Guignome01/OpenChess/BuildGuide/13_SENSOR_GLUE.webp

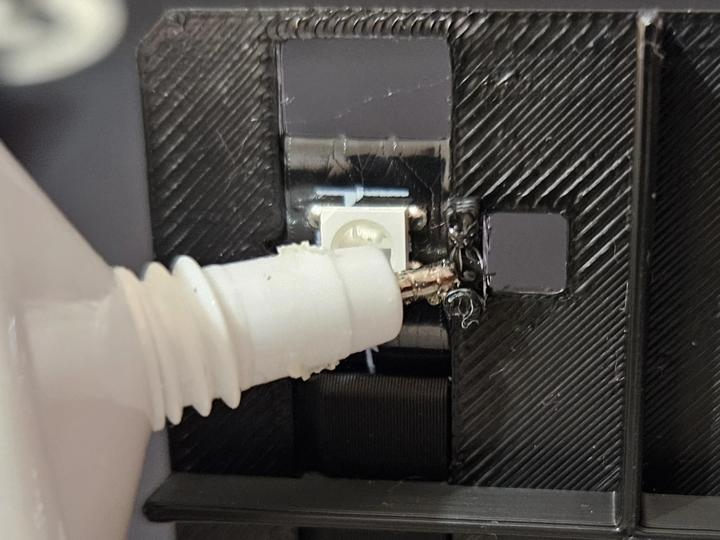
BuildGuide/13_SENSOR_GLUE.webp
