Guignome01/OpenChess/BuildGuide/39_PLASTIC_PCB_DONE_BACK.webp

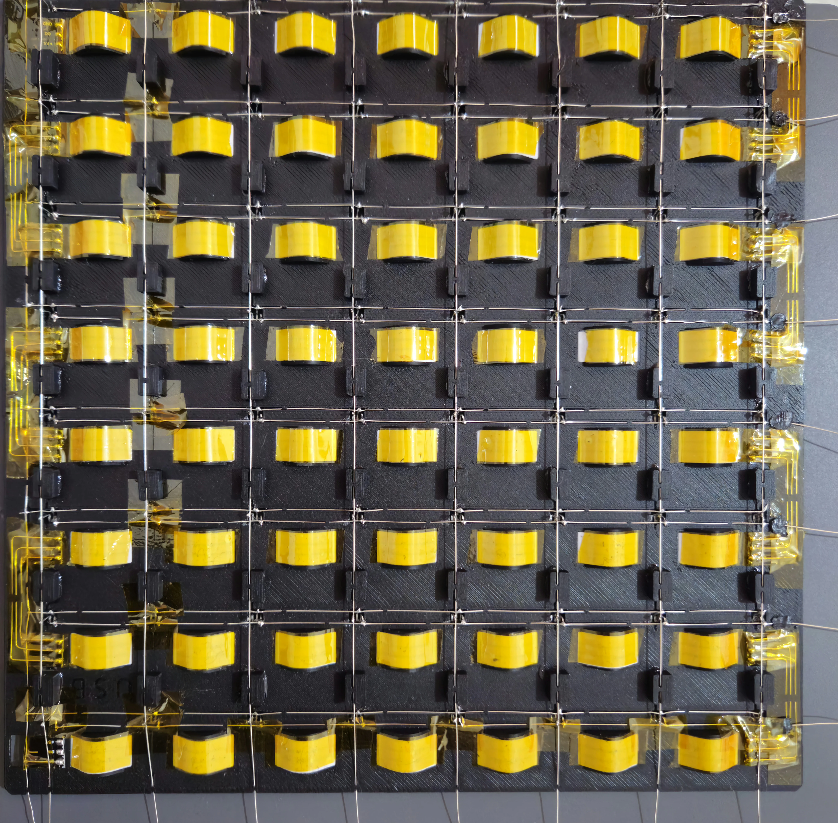
BuildGuide/39_PLASTIC_PCB_DONE_BACK.webp
