Guignome01/OpenChess/README.md

# LibreChess — Smart Chess Board

LibreChess is an open-source smart chessboard powered by an ESP32 microcontroller. It detects piece movements using hall-effect sensors, provides real-time visual feedback through an embedded LED grid, and connects to chess engines and online platforms over WiFi. Play human vs human, challenge the Stockfish engine, or join a live game on Lichess — all on a physical board with guided LED feedback.

## Features

### ♟ Gameplay
- Full chess rule enforcement: legal move validation, check, checkmate, stalemate, castling, en passant, pawn promotion
- Draw detection via 50-move rule and threefold repetition (Zobrist hashing)
- LED-highlighted valid moves on piece pickup (white for moves, red for captures, purple for en passant)
- Animated feedback for captures, promotions, check warnings, and game-ending events
- Physical resign gesture with progressive LED confirmation
- Game history saved to flash storage with crash recovery

### 🌐 Connectivity
- Play against Stockfish AI with 8 difficulty levels (beginner to master)
- Play live Lichess games on your physical board with automatic move synchronization
- WiFi management with up to 3 saved networks and automatic reconnection
- mDNS support for easy access via `librechess.local`

### 🖥 Web Interface
- Live board view with evaluation bar, move history, and move sounds
- Drag-and-drop board editor with FEN import/export
- Game history browser with full game review and PGN-style navigation
- WiFi, Lichess, LED brightness, and OTA firmware update settings
- Game mode selection and resign from the browser

## Quick Start

1. **Prerequisites** — Install [VS Code](https://code.visualstudio.com/) with the [PlatformIO IDE](https://platformio.org/install/ide?install=vscode) extension
2. **Flash** — Open the project workspace, connect your ESP32 via USB, and click Upload (`Ctrl+Alt+U`)
3. **Calibrate** — On first boot, the board runs a serial-guided calibration to map sensors and LEDs to board squares. Follow the prompts over serial monitor (115200 baud), or type `skip` to defer — but the board will ask again on each reboot until completed. See the [calibration guide](docs/guides/calibration.md).
4. **Connect** — Connect to the `LibreChess` WiFi AP (password: `chess123`), open `http://librechess.local`, and configure your WiFi network
5. **Play** — Place a piece on one of the four lit center squares to select a game mode

See the [installation guide](docs/development/installation.md) for detailed setup instructions, the [full documentation](docs/overview.md) for hardware guides and development reference, and the [roadmap](docs/roadmap.md) for planned features.

## Contributing

Contributions are welcome. Whether it's a bug fix, a new feature, or feedback on the project direction, feel free to open an issue or submit a pull request.

## License

This project is open source. See the [LICENSE](LICENSE) file for details.
