Guignome01/OpenChess/docs/development/project-structure.md

# Project Structure

A comprehensive map of the codebase, covering firmware, web frontend, build tools, and runtime storage.

## Top-Level Layout

```
├── src/                    Firmware source code and web frontend sources
├── lib/core/               Natively-compilable chess engine library (no Arduino deps)
├── test/                   Native unit tests (PlatformIO Unity framework)
├── data/                   Pre-built web assets (gzip-compressed) for LittleFS
├── docs/                   Project documentation
├── BuildGuide/             Build photos and schematics (to be updated)
├── platformio.ini          PlatformIO build configuration
├── LibreChess.code-workspace VS Code workspace file
├── grid_scan_test.cpp      Standalone sensor grid debugging utility
├── .clang-format           C++ code formatting rules (Google style base)
├── .github/                Copilot instructions, scoped instruction files, and workflow skills
├── LICENSE                 Project license
└── README.md               Project overview and quick start
```

## Firmware (`src/`)

### Core

| File | Purpose |
|---|---|
| `main.cpp` | Entry point: `setup()` and `loop()`. Game mode selection, menu routing, WiFi/resign/board-edit relay, and game lifecycle management. |
| `board_driver.h/.cpp` | Hardware abstraction: LED strip (NeoPixelBus, I2S DMA), sensor grid (shift register scan + GPIO reads), calibration (NVS-persisted), LED settings (brightness, dimming), and async animation queue (FreeRTOS task + queue). GPIO pin definitions. |
| `system_utils.h/.cpp` | Arduino/ESP32 utility functions: `colorLed()` (piece char → LED color), `ensureNvsInitialized()` (Preferences guard). Not available in native tests. |
| `led_colors.h` | `LedRGB` struct and named color constants (Cyan, White, Red, Green, Yellow, Purple, Orange, Blue, etc.) with `scaleColor()` brightness helper. |

### Game Modes

| File | Purpose |
|---|---|
| `game_mode/game_mode.h/.cpp` | Abstract base class for all game modes. Holds a `Game*` that orchestrates chess state, recording, and observer notification. Implements shared logic: `tryPlayerMove()`, `applyMove()` (delegates to `Game::makeMove()`; the string overload parses coordinate notation), `waitForBoardSetup()`, `tryResumeGame()`, resign gesture handling, and LED feedback helpers. No longer includes `movegen.h + rules.h` directly — all chess queries go through the game orchestrator. |
| `game_mode/bot_mode.h/.cpp` | Concrete class for human-vs-engine play (composition pattern). Composes an `EngineProvider*` via strategy injection. Non-blocking `update()` drives an async state machine (`BotState::PLAYER_TURN` / `BotState::ENGINE_THINKING`): player turn → `tryPlayerMove()` → `applyMove()` → `provider_->onPlayerMoveApplied()`; engine turn → `provider_->requestMove()` (spawns FreeRTOS task) → polls `provider_->checkResult()` each tick. Provides thinking animation helpers, remote-move LED guidance (`waitForRemoteMoveCompletion()`), and resign hooks that delegate to the provider. |
| `game_mode/player_mode.h/.cpp` | Human vs Human mode. Minimal subclass of `GameMode` — implements `begin()` (board setup, game recording) and `update()` (sensor polling, move processing). |
| `sensor_test.h/.cpp` | Standalone sensor diagnostic mode (does not inherit `GameMode`). Tracks visited squares, lights them white, completes when all 64 are visited. |

### Engine Providers

| File | Purpose |
|---|---|
| `engine/engine_provider.h` | `EngineProvider` base class. Defines the contract for all chess engines: `initialize()`, `requestMove()` / `checkResult()` / `cancelRequest()` (async move computation), `onPlayerMoveApplied()`, `onResignConfirmed()`, `getEvaluation()`. Also owns the shared FreeRTOS task lifecycle (`BaseTaskContext`, `spawnTask()`, `pollResult()`, `peekResult()`, `finishTask()`). Defines `EngineResult` (move/game-end data) and `EngineInitResult` (player color, FEN, mode, depth, resume flag). |
| `engine/stockfish/stockfish_provider.h/.cpp` | `StockfishProvider`: extends `EngineProvider`, spawns a one-shot FreeRTOS task per move that calls `StockfishAPI`. `TaskContext` extends `BaseTaskContext` with FEN, depth, and evaluation fields. Retry logic with cancel checking between attempts. |
| `engine/stockfish/stockfish_api.h/.cpp` | Stockfish API client. Builds request URLs, parses JSON responses (evaluation, best move, continuation). Connects to `stockfish.online` over HTTPS. |
| `engine/stockfish/stockfish_settings.h` | 8 difficulty presets (beginner through master, depths 1–15, scaled timeouts 10s–65s). `StockfishSettings::fromLevel(int)` factory. |
| `engine/lichess/lichess_provider.h/.cpp` | `LichessProvider`: extends `EngineProvider`, blocking `initialize()` discovers active games (token verification + event polling). `requestMove()` spawns a FreeRTOS task that opens a persistent NDJSON stream and reads events; reconnects with exponential backoff on connection loss. `onPlayerMoveApplied()` sends moves to Lichess with retries. `onResignConfirmed()` resigns on the server. |
| `engine/lichess/lichess_api.h/.cpp` | Lichess API client. Token management, game event polling, persistent game stream (`connectGameStream()` / `readStreamEvent()`), move submission, and resignation. Connects to `lichess.org` over HTTPS. |
| `engine/lichess/lichess_config.h` | `LichessConfig` struct: holds the Lichess API token. |
| `engine/librechess/librechess_provider.h/.cpp` | `LibreChessProvider`: extends `EngineProvider`, runs the on-board search engine in-process. Each `requestMove()` spawns a FreeRTOS task (16 KiB stack) that creates a `UCIHandler` with heap-sized TT, sends `position fen` + `go depth/movetime`, and extracts the `bestmove` response. Cancellation via `setExternalStop()`. No network required. |
| `engine/librechess/librechess_serial.h` | `SerialUCIStream`: `UCIStream` implementation over hardware UART. Enables external UCI GUIs (Arena, CuteChess) to drive the engine over Serial. |

### Infrastructure

| File | Purpose |
|---|---|
| `wifi_manager_esp32.h/.cpp` | WiFi connection management (state machine with AP/STA modes), async web server (ESPAsyncWebServer), all HTTP API endpoints, mDNS, known-networks registry (NVS), OTA password management, and board state relay to the web UI. |
| `littlefs_storage.h/.cpp` | Concrete `IGameStorage` backed by LittleFS. Manages `/games/` directory, binary game files (header + moves + FEN table), storage limits enforcement, and JSON game list API for the web UI. |
| `serial_logger.h/.cpp` | Concrete `ILogger` using Arduino `Serial`. |
| `board_menu.h/.cpp` | Reusable board menu primitive. Displays options as colored LEDs, uses two-phase debounce for selection, supports orientation flipping, back buttons, and blink feedback. Also provides `boardConfirm()` dialog. |
| `menu_navigator.h/.cpp` | Stack-based menu orchestrator (max depth 4). Push/pop navigation, auto back-button handling, parent menu re-display. |
| `menu_config.h/.cpp` | Menu layout definitions. `MenuId` namespace with ID ranges per level, `constexpr MenuItem[]` arrays for each menu, extern menu/navigator instances, and `initMenus()` two-phase initializer. |

## Web Frontend (`src/web/`)

The ESP32 serves a web interface directly from flash storage. The frontend is built with vanilla HTML, CSS, and JavaScript — no build framework or SPA router. Each page is a self-contained HTML file that includes shared scripts.

### Pages

| File | Purpose |
|---|---|
| `index.html` | Home and settings page. WiFi network management, Lichess token, LED brightness/dimming, board recalibration, OTA firmware upload, and OTA password security. |
| `board.html` | Board view and interaction page. Live board display with evaluation bar, move history with navigation, board editor (drag-and-drop, FEN, castling/en-passant controls), game history browser, game review mode, settings popup (themes, colors, sounds), focus mode, and resign button. |
| `game.html` | Game mode selection page. Four mode cards with bot configuration panel (color, difficulty). Redirects to board page after selection. |

### Scripts (`src/web/scripts/`)

| File | Purpose |
|---|---|
| `api.js` | Low-level HTTP utilities: `getApi()`, `postApi()`, `deleteApi()` fetch wrappers and `pollHealth()` for OTA reboot polling. |
| `provider.js` | Domain-specific API client. `Api` object with named methods for every backend endpoint (e.g., `Api.getNetworks()`, `Api.resign()`, `Api.selectGame()`). All pages use `Api.*` methods — no page contains raw fetch calls. |
| `Position-1.0.0.min.js` | Third-party Position rendering library. |
| `jquery-4.0.0.min.js` | jQuery (dependency of Position.js). |

### Styles (`src/web/css/`)

| File | Purpose |
|---|---|
| `styles.css` | Application styles. Dark theme, responsive layout, game mode cards, board controls, evaluation bar, FEN editor, OTA dropzone, settings popup, game history cards, review panel. |
| `Position-1.0.0.min.css` | Third-party Position styles. |

### Assets

- `src/web/pieces/` — SVG chess piece images (12 files: `wK.svg`, `bQ.svg`, etc.)
- `src/web/sounds/` — Move sounds (`move.nogz.mp3`, `capture.nogz.mp3`). The `.nogz.` naming convention prevents gzip compression in the build pipeline — these are served as raw binary files.

## Chess Engine Library (`lib/core/`)

The `lib/core/` library contains all natively-compilable chess logic with zero Arduino dependencies. PlatformIO's Library Dependency Finder auto-discovers it for both the ESP32 and native test environments. All code uses `std::string` (not Arduino `String`); firmware call sites bridge with `.c_str()` / `std::string()`.

| File | Purpose |
|---|---|
| `library.json` | PlatformIO library descriptor. |
| `src/piece.h` | `piece` namespace (header-only): type-safe piece representation (Piece/Color/PieceType enums, bit extraction, construction, predicates, color helpers, FEN char conversion, Zobrist index, material values). |
| `src/bitboard.h` | `LibreChess` (bitboard) namespace (header-only): bitboard types (`Bitboard = uint64_t`, `Square = int`), LERF square mapping (`squareOf`, `rowOf`, `colOf`), bit manipulation (`popcount`, `lsb`, `popLsb`), file/rank masks, directional shifts (compass rose convention), `BitboardSet` struct (12 piece + 2 color + occupancy bitboards with `setPiece`/`removePiece`/`movePiece`). |
| `src/attacks.h/.cpp` | `attacks` namespace: precomputed leaper tables (`KNIGHT[64]`, `KING[64]`, `PAWN[2][64]`, ~2.5 KiB), O(1) slider functions (`rook` via first-rank table + Hyperbola Quintessence, `bishop` via HQ on diagonal masks, `queen` = rook+bishop), x-ray functions (`xrayRook`, `xrayBishop`), ray geometry (`between`, `line`), `AttackInfo` struct + `computeAll(bb)` (per-piece-type/color attack maps for evaluation/search), `isSquareUnderAttack(bb, sq, color)` (check detection via attack table lookups), `init()` initializer. |
| `src/movegen.h + rules.h/.cpp` | `movegen`/`rules` namespaces: stateless chess logic. Move generation (fills `MoveList&`), legal move filtering via copy-make on `BitboardSet`, check/checkmate/stalemate detection. All functions take `const BitboardSet& bb` + `const Piece mailbox[]`; check detection delegates to `attacks::isSquareUnderAttack()`. Position-dependent state (castling rights, en passant target) is passed in via `const PositionState&`. |
| `src/position.h/.cpp` | `Position` class: board representation and position-level chess logic — a pure position container with no lifecycle state. Owns `BitboardSet bb_` (12 piece bitboards + 2 color + occupancy), `Piece mailbox_[64]` (flat array for O(1) piece identity), current turn, and all position state via `PositionState` (castling rights, en passant, halfmove/fullmove clocks). Incremental Zobrist hash (`hash_`). King cache (`Square kingSquare_[2]`). Insufficient material detection (K vs K, K+B/N vs K, K+B vs K+B same-color). Public API: `newGame()`, `loadFEN()` → `bool` (validates FEN before applying; returns false on invalid input), `makeMove()` → `MoveResult`, `getFen()`, `getEvaluation()`, `getCastlingRights()`, `positionState()`, `bitboards()`, `mailbox()`. Convenience wrappers: `getPossibleMoves()`, `isCheck()`, `inCheck()`, `isCheckmate()`, `isStalemate()`, `isInsufficientMaterial()`, `isDraw()`, `isFiftyMoves()`, `isAttacked()`, `findPiece()`, `checkEnPassant()`, `checkCastling()`, `moveNumber()`. Note: lifecycle state (`gameOver_`, `gameResult_`, `winnerColor_`) and lifecycle methods (`endGame()`, `isGameOver()`) live in `Game`. Move history, observer notification, undo/redo, and batching also live in `Game`. |
| `src/utils.h/.cpp` | `utils` namespace: board-level helpers — board queries (`isValidSquare`), coordinate helpers (`squareName`, `fileChar`, `rankChar`, `fileIndex`, `rankIndex`), validation (`isValidPromotionChar`), castling rights formatting/parsing, special-move analysis structs (`checkEnPassant`, `checkCastling`, `updateCastlingRights`), `applyBoardTransform` (applies move to `BitboardSet` + `mailbox` + `hash`), `boardToText(mailbox)`, `gameResultName`. |
| `src/evaluation.h/.cpp` | `eval` namespace: tapered position evaluation — `evaluatePosition(bb)` computes separate midgame and endgame scores (material + phase-specific PSTs + pawn structure via file-scoped pawn mask arrays), then interpolates based on game phase (non-pawn material: N=1, B=1, R=2, Q=4; max 24). Endgame PSTs for king (centralization) and pawn (advancement) differ from midgame; other pieces share PSTs. Returns score in centipawns. Pawn-structure analysis functions (`isPassed`, `isIsolated`, `isDoubled`, `isBackward`) and `initPawnMasks()` lazy initializer. |
| `src/iterator.h` | `iterator` namespace (header-only): board iteration helpers built on bitboard serialization. `forEachSquare(mailbox, fn)` loops 0–63. `forEachPiece(bb, mailbox, fn)` iterates occupied squares via `popLsb`. `somePiece(bb, mailbox, fn)` early-exit variant. `findPiece(bb, piece, positions, max)` locates pieces via their bitboard. All callbacks receive `(row, col, piece)`. |
| `src/fen.h/.cpp` | `fen` namespace: FEN string handling — `boardToFEN()` (mailbox → FEN string), `fenToBoard()` (FEN string → `BitboardSet` + `mailbox` + state), `validateFEN()` (format validation: rank structure, piece chars, turn, castling, en passant, clocks). |
| `src/notation.h/.cpp` | `notation` namespace: move notation conversion — coordinate (`"e2e4"`), SAN (`"Nf3"`), LAN (`"Ng1-f3"`) output and parsing. All functions are pure (`const BitboardSet&` + `const Piece mailbox[]` passed in). |
| `src/types.h` | Shared chess types: `Piece`/`Color`/`PieceType` enums, `PositionState` struct (castling rights, en passant target, halfmove/fullmove clocks) with `initial()` static factory, `GameResult` enum class, `MoveResult` struct (returned by `Position::makeMove()`), `MoveEntry` struct (move log record), `Move` struct (3 bytes: from/to/flags with capture, EP, castling, promotion bits), `ScoredMove` struct (Move + int16_t score), `MoveList` struct (fixed-size `Move[218]` array + count, used by both per-piece and bulk move generation, with `targetRow`/`targetCol`/`target` adapter accessors for UI), `HashHistory` struct (Zobrist hash array + count, used by `Position`), `GameHeader` packed struct (16 bytes), `GameModeId` enum class, `MoveFormat` enum class (`COORDINATE`, `SAN`, `LAN`), storage constants (`FORMAT_VERSION`, `FEN_MARKER`, `MAX_GAMES`, `MAX_USAGE_PERCENT`), `invalidMoveResult()` factory. |
| `src/zobrist.h` | `zobrist` namespace (header-only): constexpr-generated Zobrist keys, piece-index mapping, and full-board hash computation (`computeHash(bb, mailbox, turn, state)`). `Position` uses incremental hashing via XOR deltas in `applyMoveToBoard()`; `computeHash()` is retained for debug verification. |
| `src/search.h/.cpp` | `search` namespace: on-board chess engine — negamax with alpha-beta pruning, quiescence search, iterative deepening, transposition table (`TTEntry` 12 bytes, `TranspositionTable`), move ordering (TT move → MVV-LVA → killers → history). `findBestMove(pos, limits, timeFunc, infoCallback, tt)` is the single public entry point. `SearchLimits` (depth/time/stop), `SearchResult` (bestMove/score/depth/nodes), `SearchState` (per-search heuristics). Constants: `MATE_SCORE`, `INF_SCORE`, `MAX_PLY`, `DEFAULT_TT_SIZE`. |
| `src/uci.h/.cpp` | `uci` namespace: transport-agnostic UCI protocol handler. `UCIStream` (abstract I/O), `UCIHandler` (owns Position + TT + stop flag, dispatches `uci`/`isready`/`ucinewgame`/`position`/`go`/`stop`/`quit`), `StringUCIStream` (in-memory I/O for testing/in-process use). `setExternalStop()` wires FreeRTOS cancellation. Simple time management (remaining/30 + increment/2). |
| `src/history.h/.cpp` | `History` class: in-memory game history and persistent game recording. Ordered move log (`MoveEntry` structs with full move metadata including previous position state), Zobrist hash tracking for threefold repetition detection, and game recording lifecycle (compact 2-byte move encoding via static `encodeMove()`/`decodeMove()`, manages `GameHeader`, delegates persistence to `IGameStorage`, flushes header every full turn to reduce flash wear, validates moves during replay, replays games directly into a `Position`). Fixed-size arrays (ESP32-friendly). Composed by `Game`. |
| `src/game.h/.cpp` | `Game` class: central game orchestrator. Composes `Position`, `History`, and optionally `IGameObserver`. Constructor: `(IGameStorage*, IGameObserver*, ILogger*)`. All chess-state mutations flow through this class. Handles threefold repetition detection (via Zobrist hashing), move history recording, persistent game recording (delegated to `History`), observer notification, and batching. Exposes `bitboards()` and `mailbox()` accessors, iterator helpers (`forEachSquare`, `forEachPiece`, `somePiece`), and notation convenience methods (`makeMove(string)`, `toCoordinate()`, `parseCoordinate()`, `parseMove()`, `getHistory(format)`) so firmware never needs to include core headers directly. |
| `src/logger.h` | `ILogger` abstract interface: `info()`, `error()`, and `infof()`/`errorf()` formatted helpers. |
| `src/observer.h` | `IGameObserver` abstract interface: `onBoardStateChanged(fen, evaluation)`. |
| `src/storage.h` | `IGameStorage` abstract interface: game file lifecycle (begin, append, finalize, discard), read-back for replay, and storage management. |

## Unit Tests (`test/`)

Native unit tests using the PlatformIO Unity framework. All engine tests are consolidated in a single `test_core/` suite.

```
test/
├── test_helpers.h                  Shared utilities (setupInitialBoard, clearBoard, placePiece, etc.)
└── test_core/
    ├── test_core.cpp             Main entry: setUp/tearDown, shared globals, register calls
    ├── test_attacks.cpp                 attacks: leaper tables, slider attacks (+ bulk reference cross-check), x-ray attacks, geometry rays, AttackInfo
    ├── test_bitboard.cpp                LibreChess: square mapping roundtrip, bit ops, square-color masks, BitboardSet mutations
    ├── test_evaluation.cpp              eval: material scoring, pawn structure, tapered evaluation, pawn analysis functions
    ├── test_fen.cpp                     FEN round-trip, boardToFEN/fenToBoard, validateFEN (valid/invalid positions, fields)
    ├── test_game.cpp                    Game: threefold repetition, draw detection, observer notification/batching, history
    ├── test_history.cpp                 History: move log with undo/redo, branch-on-undo
    ├── test_history_persistence.cpp     History recording: persistence lifecycle, header flush, replay, branch-truncation, compact encode/decode
    ├── test_iterator.cpp                Board iteration: forEachSquare, forEachPiece, somePiece, findPiece
    ├── test_movegen.cpp                 Move generation per piece type, captures, bulk generation, legal move queries
    ├── test_notation.cpp                Coordinate/SAN/LAN output and parsing, auto-format detection, roundtrip
    ├── test_piece.cpp                   piece: type extraction, predicates, FEN chars, material values, Zobrist index, color helpers
    ├── test_position.cpp                Position: moves, special moves, draws, FEN, API queries
    ├── test_rules.cpp                   rules: check/checkmate/stalemate, pin-aware generation, castling, en passant, promotion
    ├── test_utils.cpp                   utils: 50-move rule, castling rights, coordinate helpers, board transforms
    ├── test_zobrist.cpp                 Zobrist hashing: key determinism, computeHash, position sensitivity
    ├── test_search.cpp                  search: mate-in-1, captures, quiescence, stalemate avoidance, iterative deepening, time/stop control, TT store/probe/clear/pack/mate-score, move ordering
    └── test_uci.cpp                     uci: id/isready output, position startpos/fen/moves, go depth/info, newgame, quit, unknown commands, loop
    ├── test_search.cpp                  search: mate-in-1, captures, quiescence, stalemate avoidance, iterative deepening, time/stop control, TT store/probe/clear/pack/mate-score, move ordering
    └── test_uci.cpp                     uci: id/isready output, position startpos/fen/moves, go depth/info, newgame, quit, unknown commands, loop
```

Run with `pio test -e native`. See [PlatformIO Unit Testing docs](https://docs.platformio.org/en/latest/advanced/unit-testing/index.html).

## Build Scripts (`src/web/build/`)

| File | Purpose |
|---|---|
| `minify.py` | Pre-build: minifies HTML/CSS/JS from `src/web/` → `src/web/build/`. Skips gracefully if npm tools aren't installed. |
| `prepare_littlefs.py` | Pre-build: gzip-compresses web assets into `data/` for LittleFS. Respects the `.nogz.` convention. Cleans intermediate files after. |
| `upload_fs.py` | Build hook: hashes `data/` contents and only uploads the LittleFS image when assets change. |

## Filesystem (`data/`)

The `data/` directory contains pre-built, gzip-compressed web assets ready for LittleFS upload. This directory is committed to the repository so the project can be built and flashed without npm minification tools.

```
data/
├── index.html.gz
├── board.html.gz
├── game.html.gz
├── favicon.svg.gz
├── css/          *.css.gz
├── scripts/      *.js.gz
├── pieces/       *.svg.gz
└── sounds/       *.mp3 (raw, not gzipped)
```

`ESPAsyncWebServer` detects `.gz` files and serves them with `Content-Encoding: gzip` automatically. Sound files are served raw with `setTryGzipFirst(false)`.

## LittleFS Runtime Layout

At runtime, the firmware creates additional files on the LittleFS partition:

```
/games/
├── live.bin        Active game data (header + moves) — crash recovery
├── live_fen.bin    Active game FEN snapshots — crash recovery
├── 0001.bin        Completed game #1
├── 0001_fen.bin    FEN table for game #1
├── ...
```

Storage limits: maximum 50 saved games, capped at 80% of LittleFS capacity.

## Configuration

LibreChess has no editable configuration file. All settings are persisted in ESP32 NVS (non-volatile storage) and managed through the web UI or code constants:

| Setting | Storage | How to Change |
|---|---|---|
| WiFi networks (up to 3) | NVS `"wifiNets"` | Web UI WiFi Settings |
| Lichess API token | NVS `"wifiCreds"` | Web UI Lichess Settings |
| OTA password | NVS `"ota"` (salted SHA-256) | Web UI Security Settings |
| LED brightness | NVS `"boardSettings"` | Web UI Board Settings |
| Dark square dimming | NVS `"boardSettings"` | Web UI Board Settings |
| Calibration data | NVS `"calibration"` | Auto (first boot) or Web UI recalibrate button |
| GPIO pin assignments | `board_driver.h` `#define`s | Edit source code |
| Board, framework, libraries | `platformio.ini` | Edit file |
| Factory reset | `platformio.ini` build flag | Add `-DFACTORY_RESET` to `build_flags` |
