Guignome01/OpenChess/BuildGuide/46_GLUE_PARCHMENT_PAPER.webp

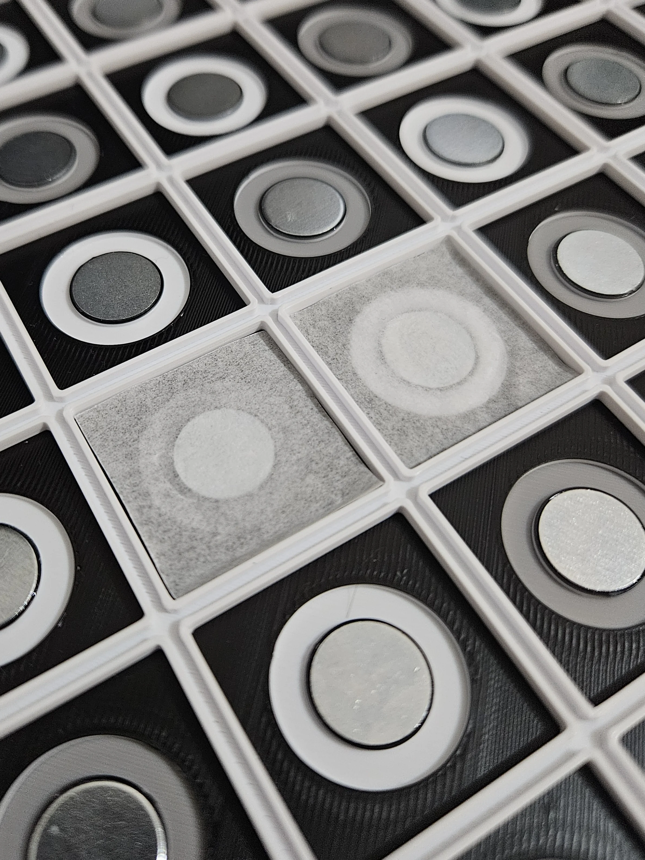
BuildGuide/46_GLUE_PARCHMENT_PAPER.webp
