Guignome01/OpenChess/BuildGuide/schematics/ESP32_PCB.webp

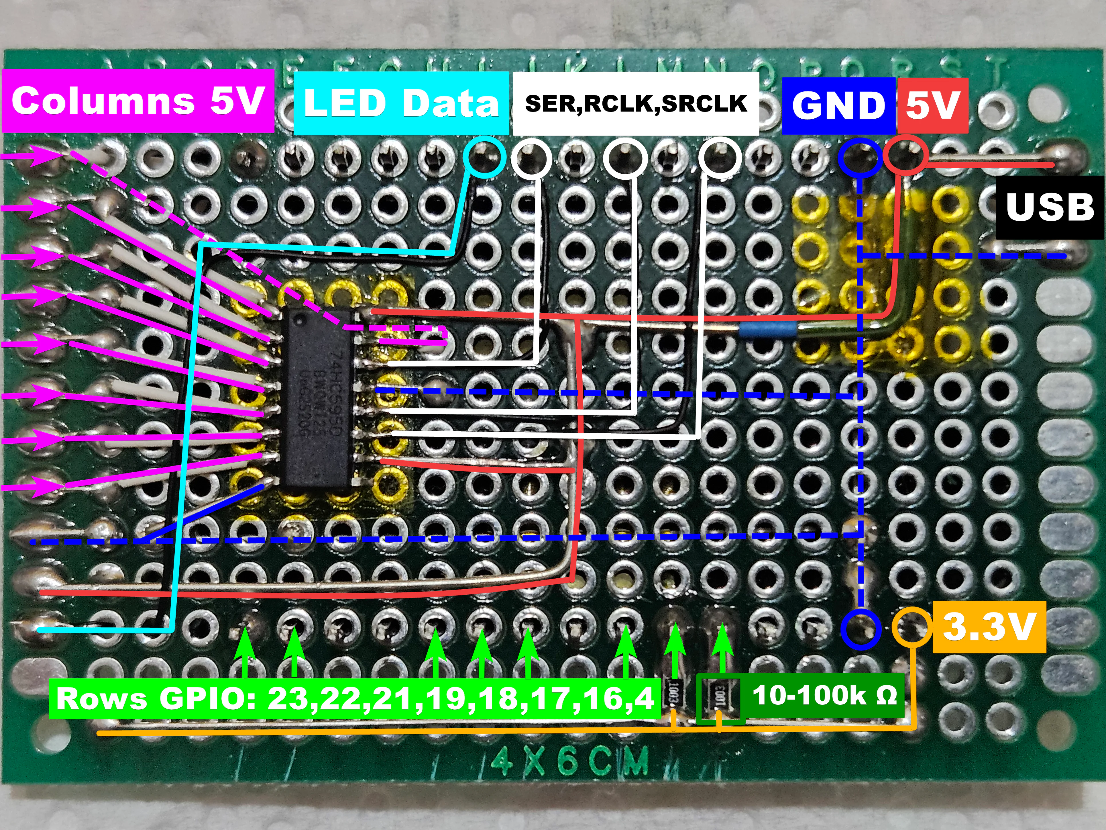
BuildGuide/schematics/ESP32_PCB.webp
