Guignome01/OpenChess/BuildGuide/schematics/NPN.webp

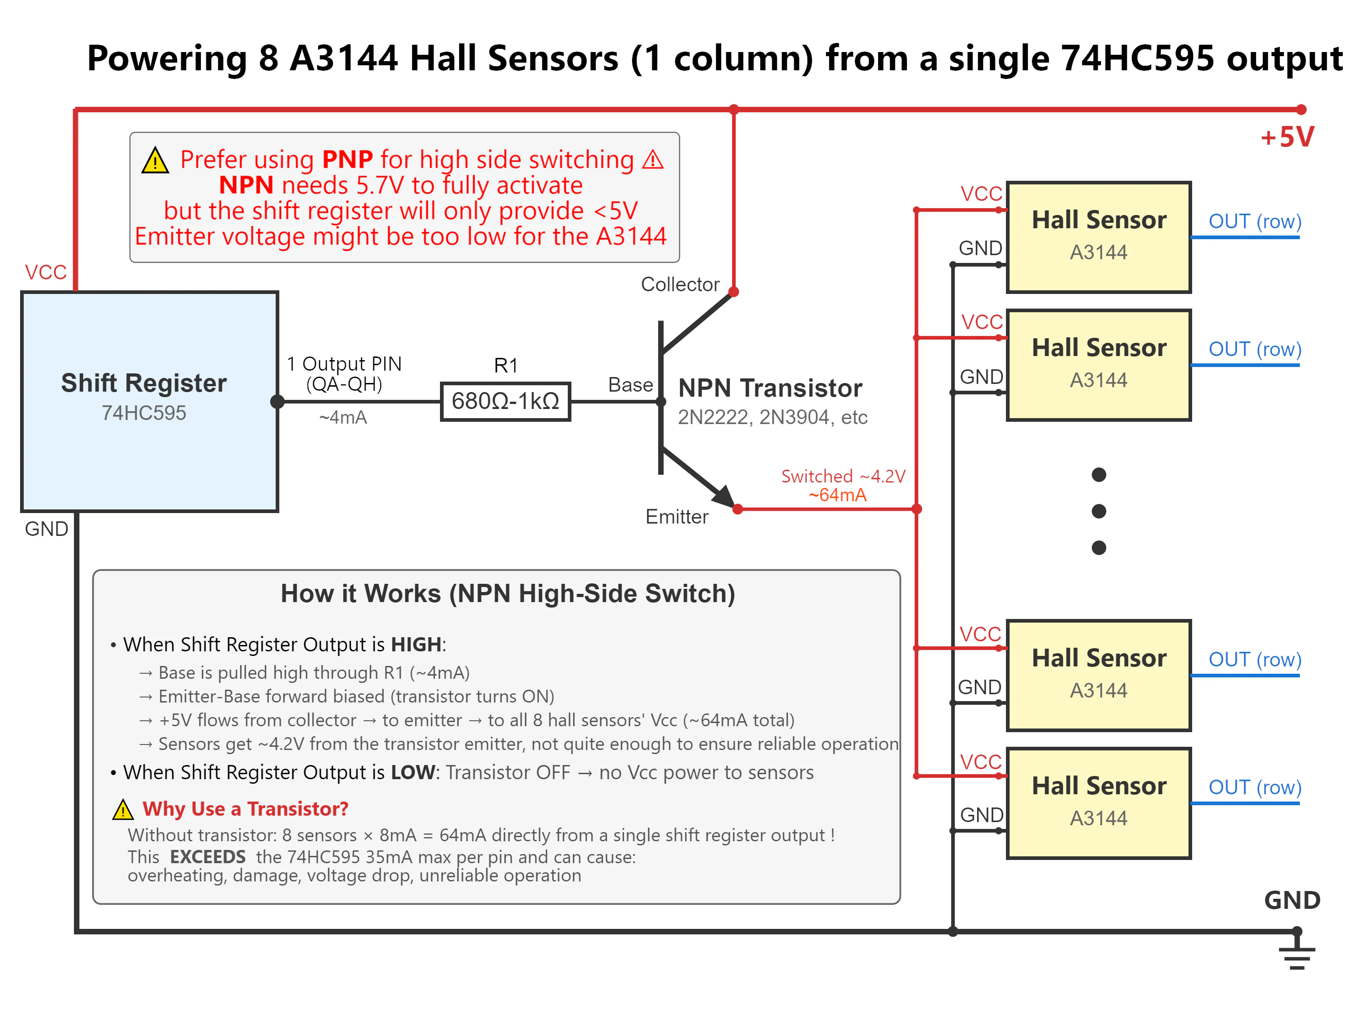
BuildGuide/schematics/NPN.webp
