Guignome01/OpenChess/BuildGuide/schematics/original_PCB.webp

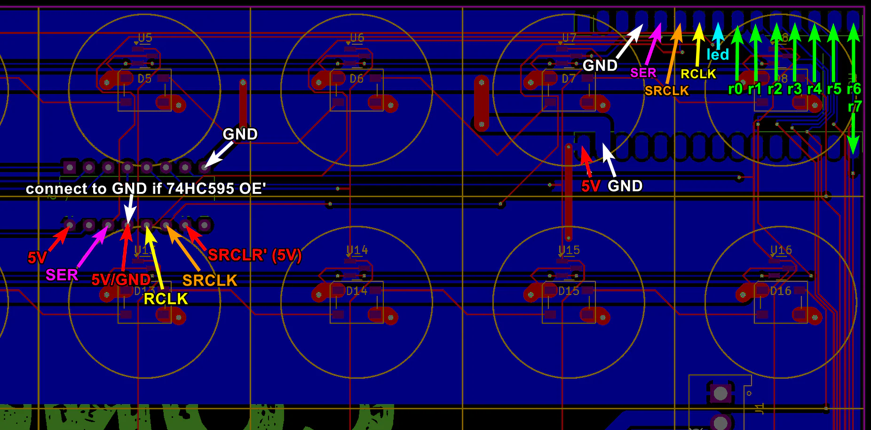
BuildGuide/schematics/original_PCB.webp
