Guignome01/OpenChess/BuildGuide/schematics/original_PCB_grid.webp

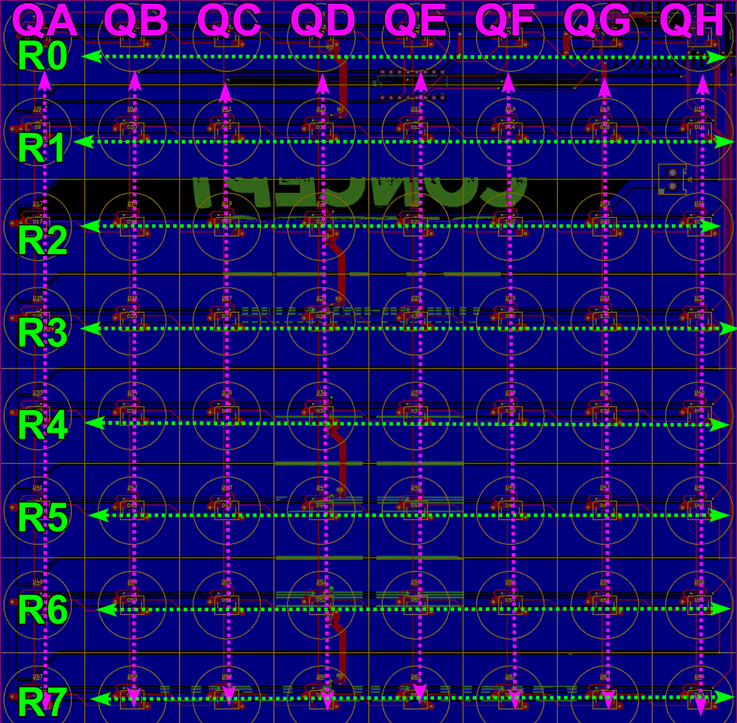
BuildGuide/schematics/original_PCB_grid.webp
