Guignome01/OpenChess/BuildGuide/schematics/Plastic_PCB.webp

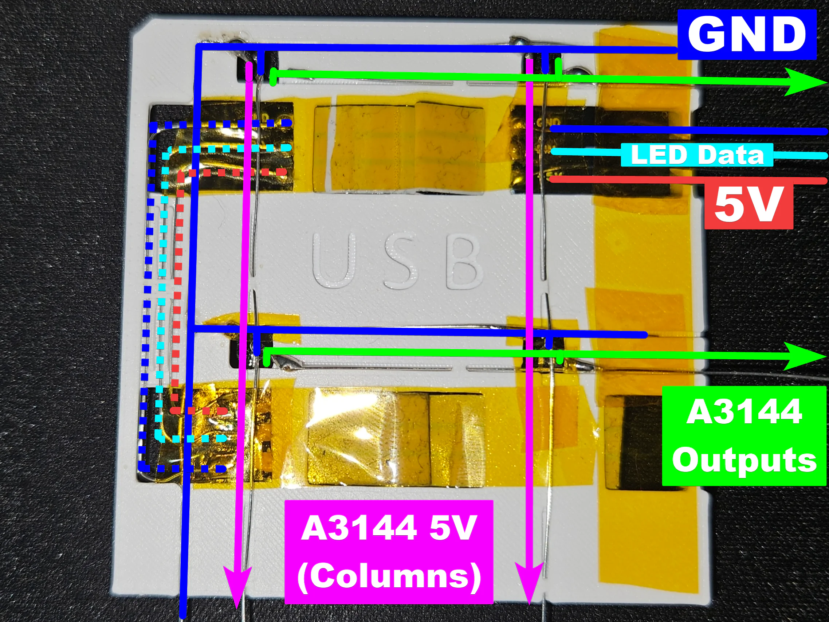
BuildGuide/schematics/Plastic_PCB.webp
