Guignome01/OpenChess/BuildGuide/schematics/PNP.webp

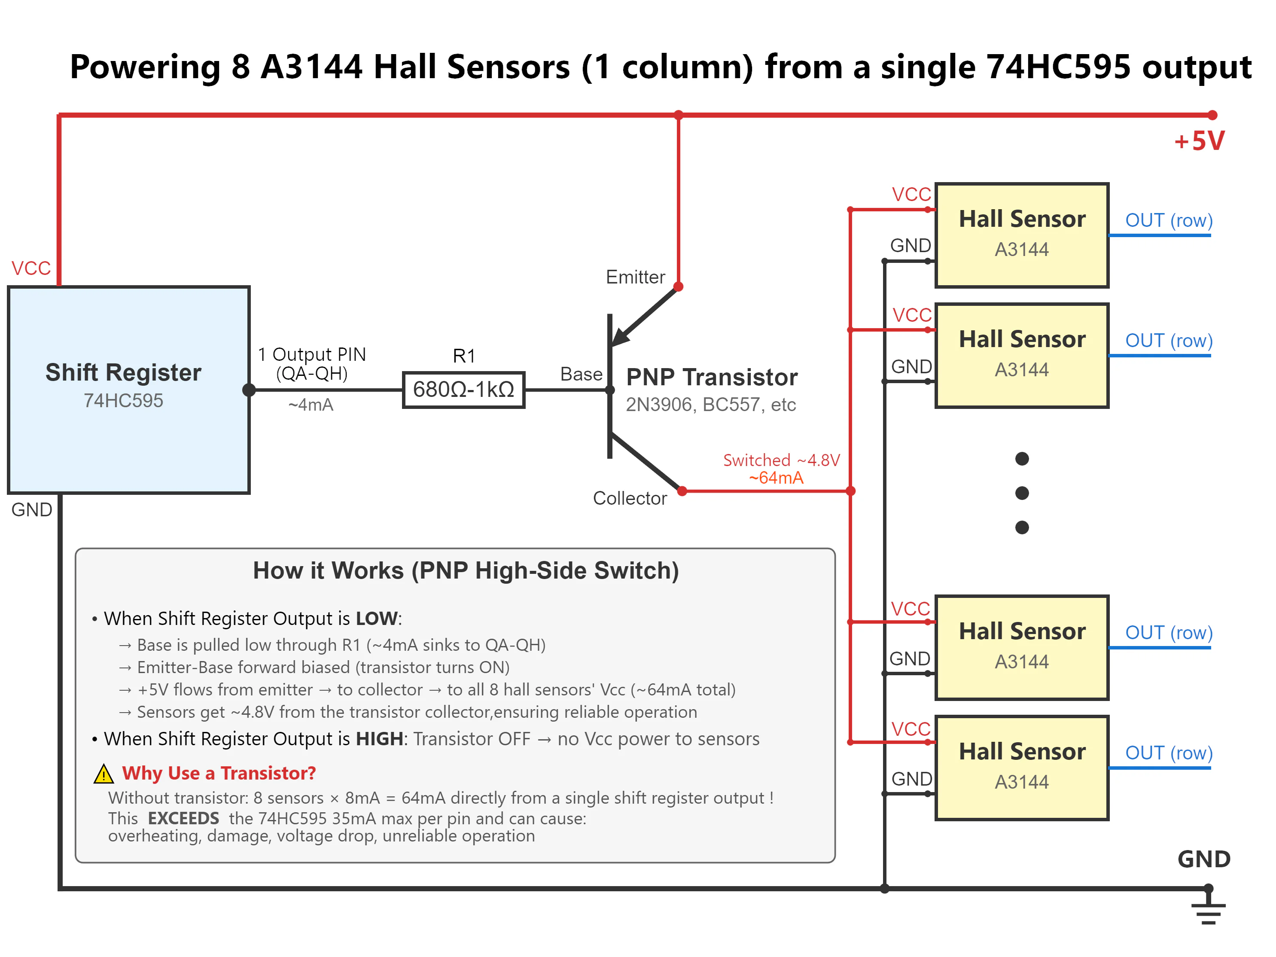
BuildGuide/schematics/PNP.webp
