Guignome01/OpenChess/.github/instructions/frontend.instructions.md

---
description: "Use when modifying web frontend files — HTML pages, JavaScript, CSS, or the API provider layer. Covers the two-file API pattern, page structure, asset pipeline, and frontend conventions."
applyTo: "src/web/**"
---

# Web Frontend Conventions

## Architecture

The ESP32 serves a web interface from LittleFS flash storage. Vanilla HTML, CSS, and JavaScript — no build framework or SPA router. Each page is a self-contained HTML file that includes shared scripts.

## Pages

| File | Purpose |
|---|---|
| `index.html` | Home / settings: WiFi management, Lichess token, LED brightness/dimming, recalibration, OTA upload, OTA password |
| `board.html` | Board view: live display, evaluation bar, move history with navigation, board editor (drag-and-drop, FEN, castling/EP controls), game history browser, review mode, settings popup (themes, colors, sounds), focus mode, resign |
| `game.html` | Mode selection: four mode cards, bot config panel (color, difficulty). Redirects to board page after selection |

## API Layer (Two-File Pattern)

All server communication uses a strict two-file pattern:

1. **`api.js`** — low-level utilities only:
   - `getApi(url)`, `postApi(url, body)`, `deleteApi(url)` — fetch wrappers
   - `pollHealth()` — OTA reboot detection polling
   - No domain logic here

2. **`provider.js`** — domain-specific `Api` object:
   - Named method for every backend endpoint (e.g., `Api.getBoardUpdate()`, `Api.resign()`, `Api.selectGame()`)
   - All pages use `Api.*` methods — **no raw `fetch()` calls in HTML pages**
   - When adding a new backend endpoint, always add a corresponding method here

## Asset Pipeline

- **Edit in `src/web/`** — HTML, CSS, JS, SVG, MP3
- **Never edit `data/` directly** — it's generated by build scripts
- Build pipeline: `minify.py` (minification) → `prepare_littlefs.py` (gzip + place in `data/`) → `upload_fs.py` (hash-based conditional upload)
- Files named `*.nogz.*` skip gzip (used for binary assets like `.mp3` that don't benefit from gzip)
- The `data/` directory is committed to git

## Scripts

| File | Purpose |
|---|---|
| `api.js` | Low-level fetch wrappers + OTA polling |
| `provider.js` | `Api` object — named methods for every endpoint |
| `chessboard-1.0.0.min.js` | Third-party board rendering library |
| `jquery-4.0.0.min.js` | jQuery (chessboard.js dependency) |

## Styles

| File | Purpose |
|---|---|
| `styles.css` | App styles: dark theme, responsive layout, game cards, board controls, eval bar, FEN editor, OTA dropzone, settings popup, game history, review panel |
| `chessboard-1.0.0.min.css` | Third-party board styles |

## Assets

- `pieces/` — 12 SVG chess pieces (`wK.svg`, `bQ.svg`, etc.)
- `sounds/` — Move sounds (`move.nogz.mp3`, `capture.nogz.mp3`)
