Guignome01/OpenChess/BuildGuide/0_PCB_BOTTOM.webp

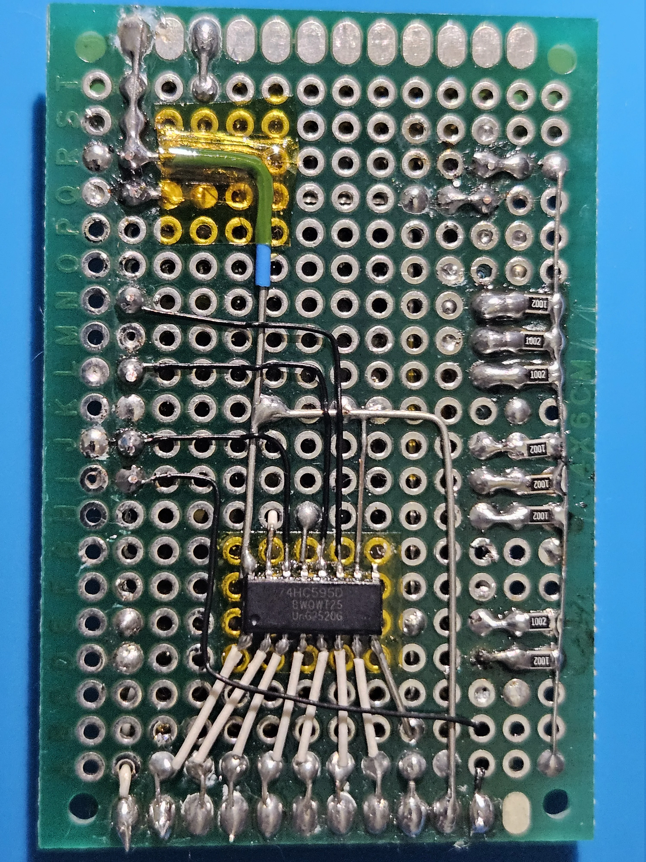
BuildGuide/0_PCB_BOTTOM.webp
