Guignome01/OpenChess/BuildGuide/1_PCB_TOP.webp

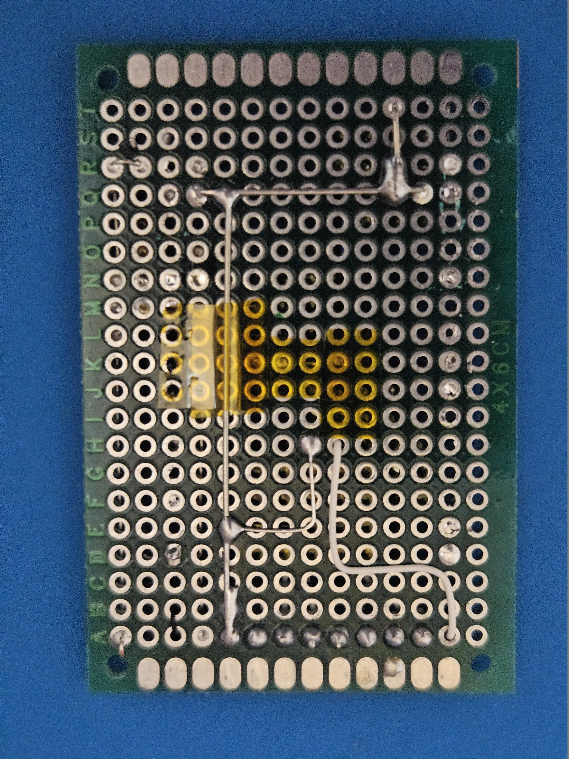
BuildGuide/1_PCB_TOP.webp
