Guignome01/OpenChess/BuildGuide/2_PCB_TOP_W_ESP32.webp

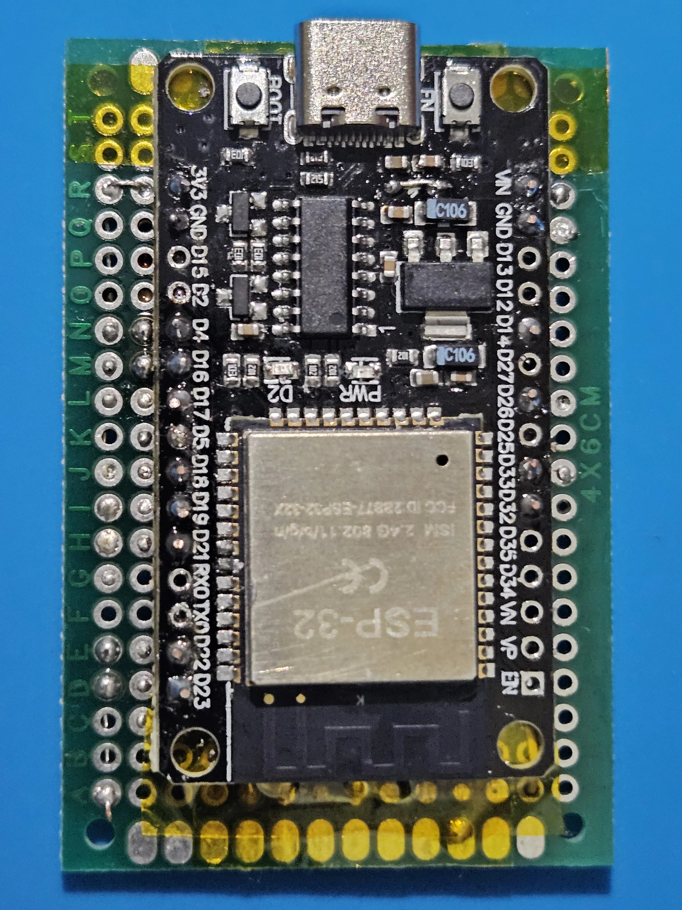
BuildGuide/2_PCB_TOP_W_ESP32.webp
