Guignome01/OpenChess/BuildGuide/3_PCB_THICKNESS.webp

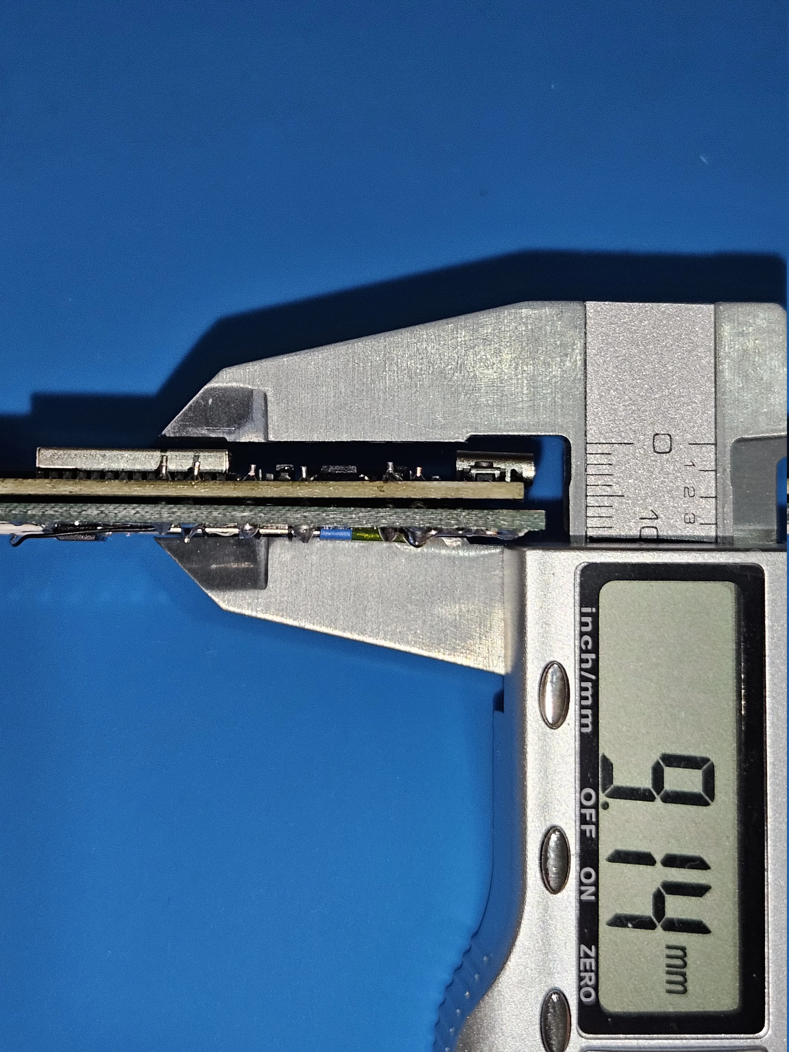
BuildGuide/3_PCB_THICKNESS.webp
