Guignome01/OpenChess/BuildGuide/4_CUT_LED_STRIP.webp

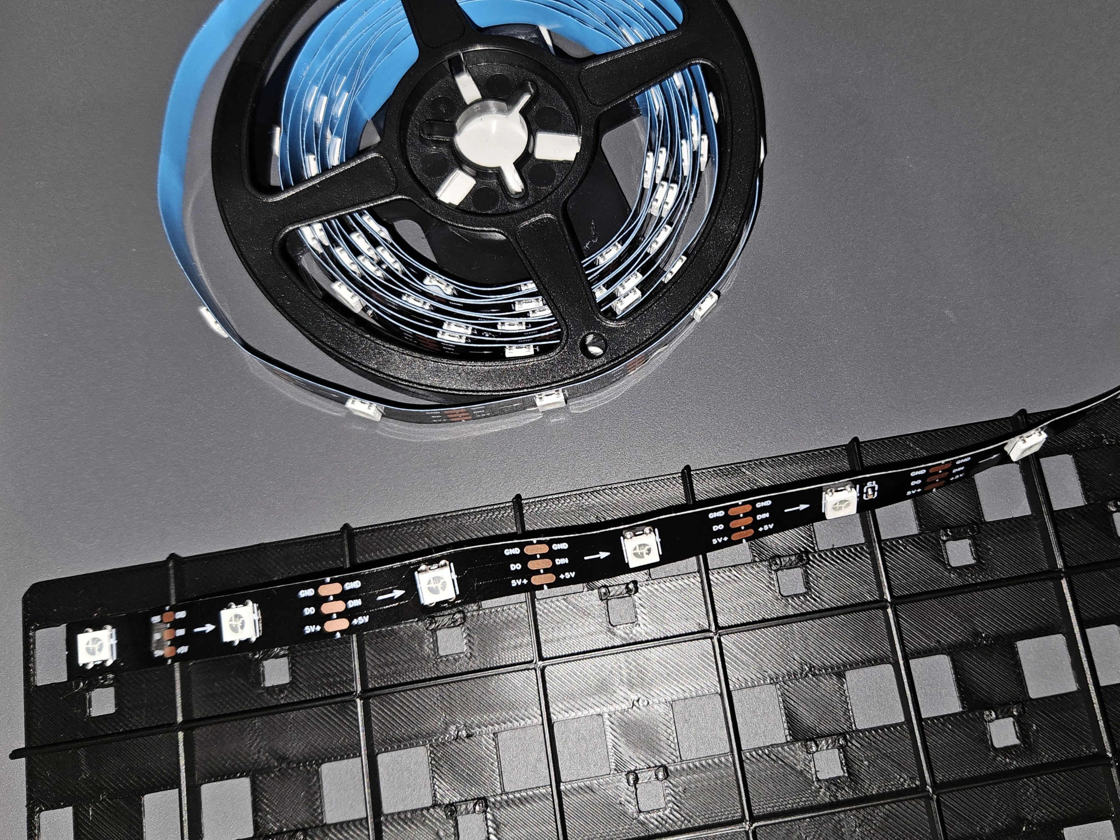
BuildGuide/4_CUT_LED_STRIP.webp
