Guignome01/OpenChess/BuildGuide/5_GLUE_1_END.webp

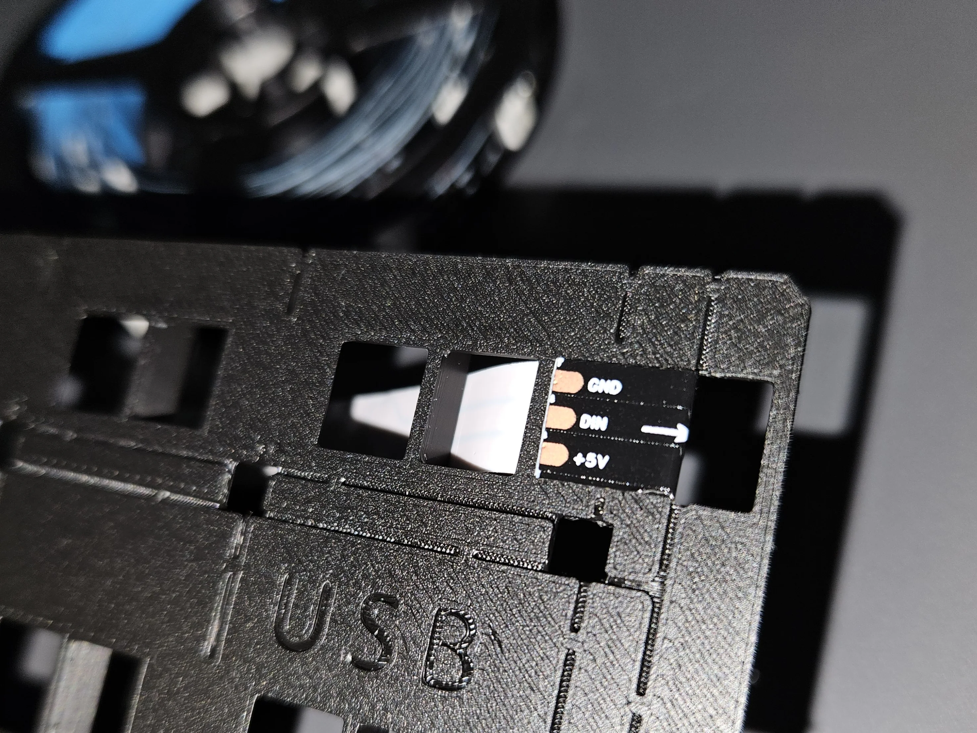
BuildGuide/5_GLUE_1_END.webp
