Guignome01/OpenChess/BuildGuide/6_SERPENTINE_ROUTING.webp

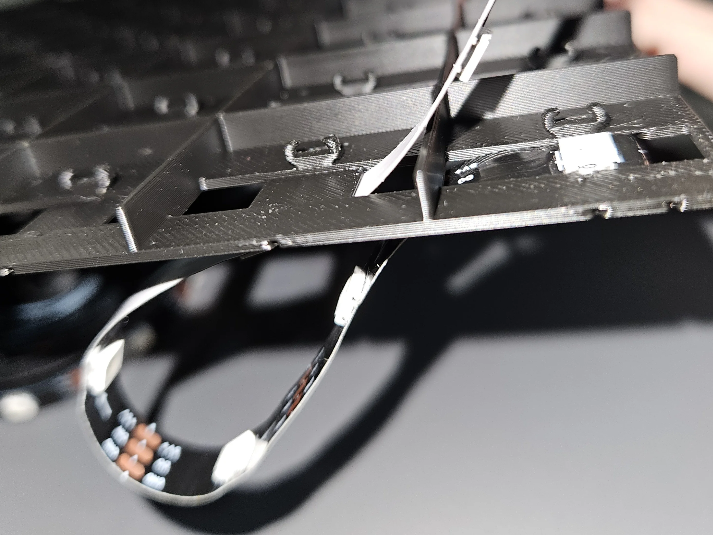
BuildGuide/6_SERPENTINE_ROUTING.webp
