Guignome01/OpenChess/BuildGuide/7_SERPENTINE_ROUTING.webp

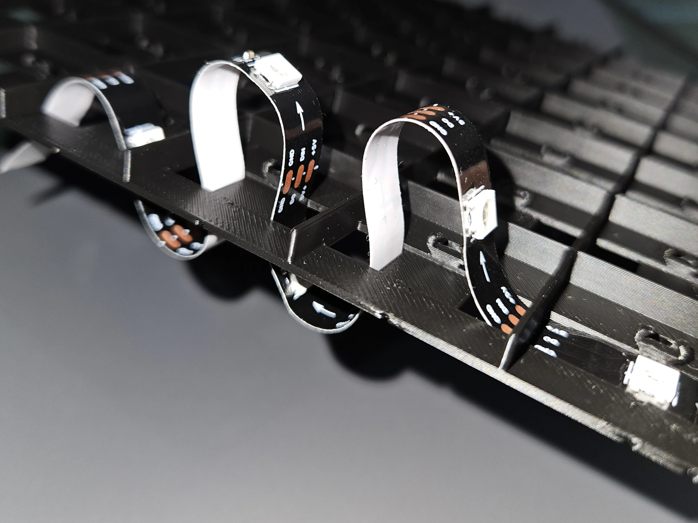
BuildGuide/7_SERPENTINE_ROUTING.webp
