Guignome01/OpenChess/BuildGuide/8_SERPENTINE_ROUTING.webp

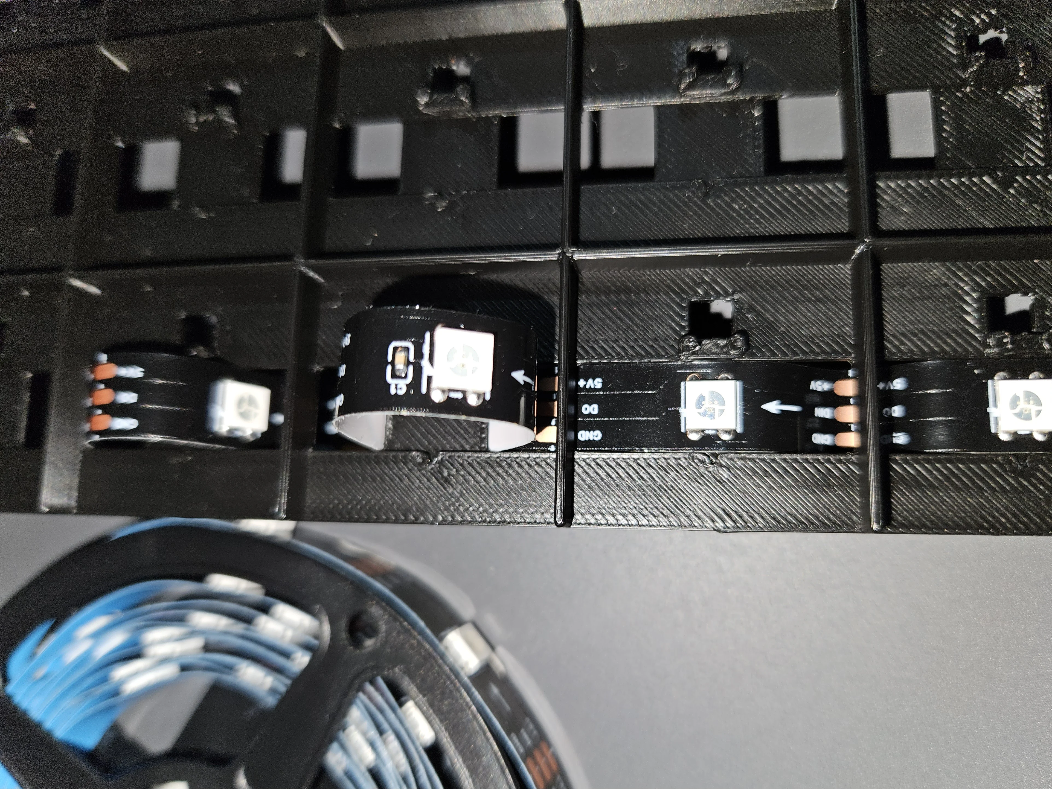
BuildGuide/8_SERPENTINE_ROUTING.webp
