Guignome01/OpenChess/BuildGuide/9_STRIP_DONE_FRONT.webp

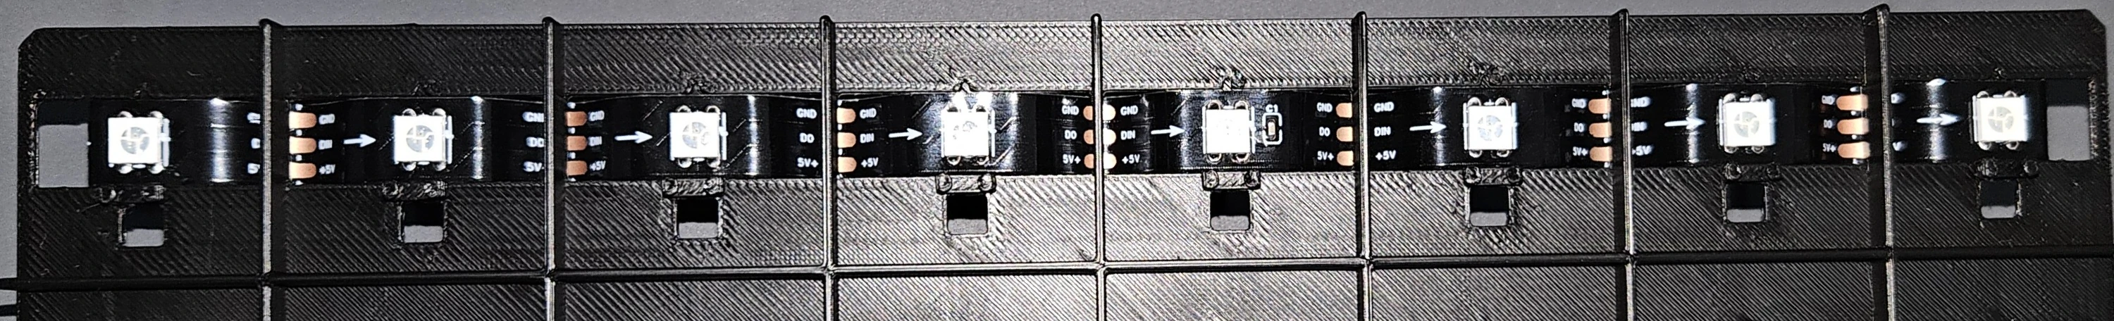
BuildGuide/9_STRIP_DONE_FRONT.webp
