Guignome01/OpenChess/BuildGuide/10_STRIP_DONE_BACK.webp

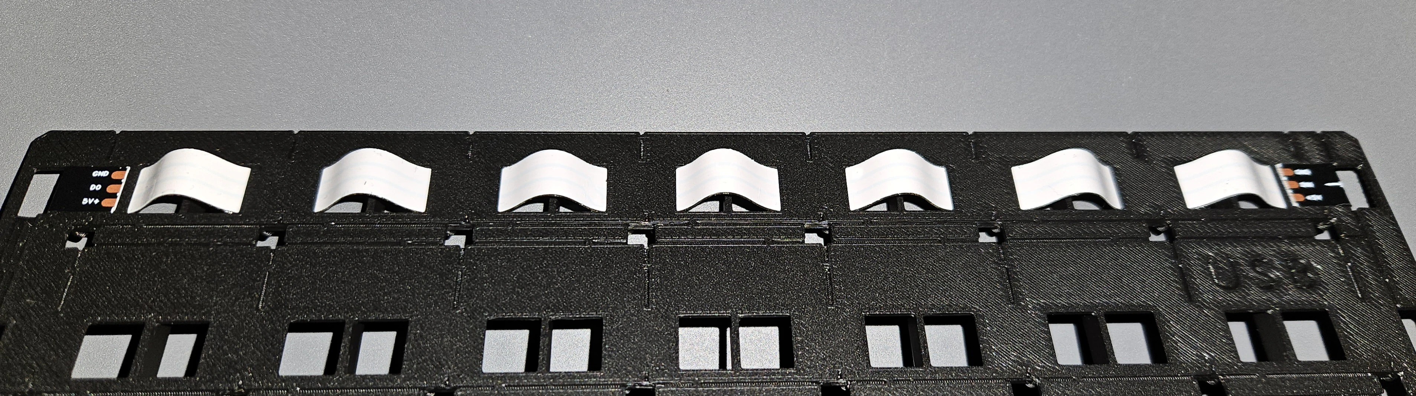
BuildGuide/10_STRIP_DONE_BACK.webp
