Guignome01/OpenChess/BuildGuide/11_STRIP_DONE_FRONT_W_SPACER.webp

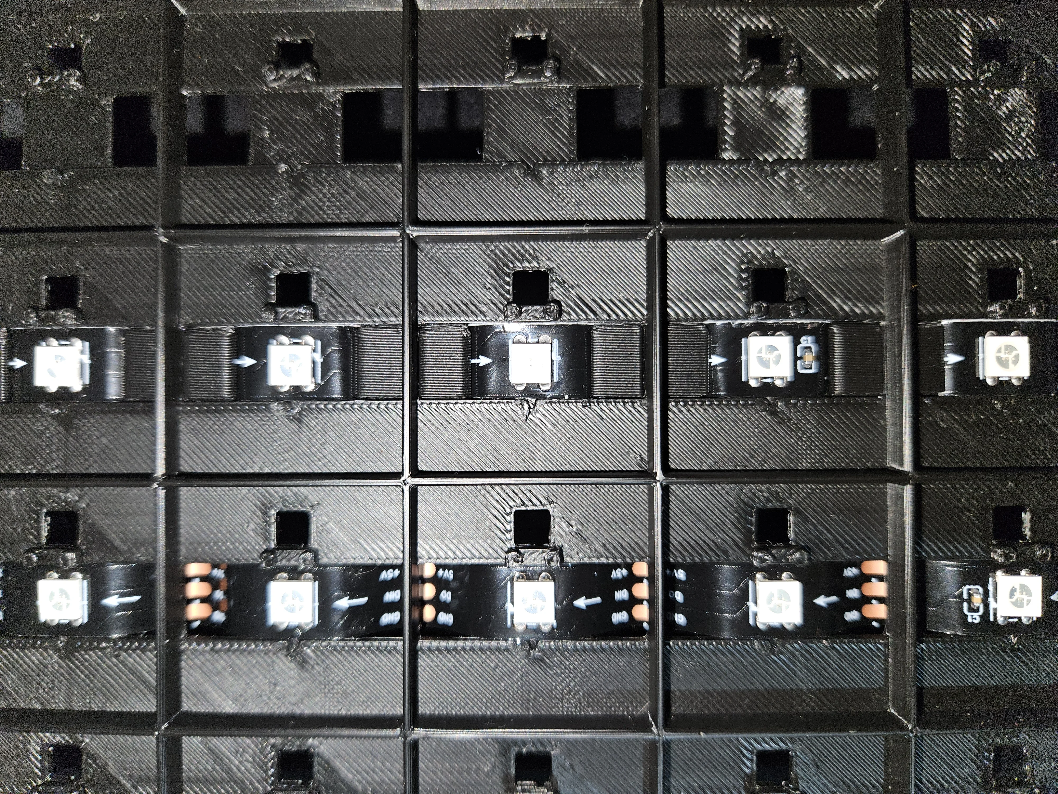
BuildGuide/11_STRIP_DONE_FRONT_W_SPACER.webp
