Guignome01/OpenChess/BuildGuide/12_STRIP_DONE_BACK_W_SPACER.webp

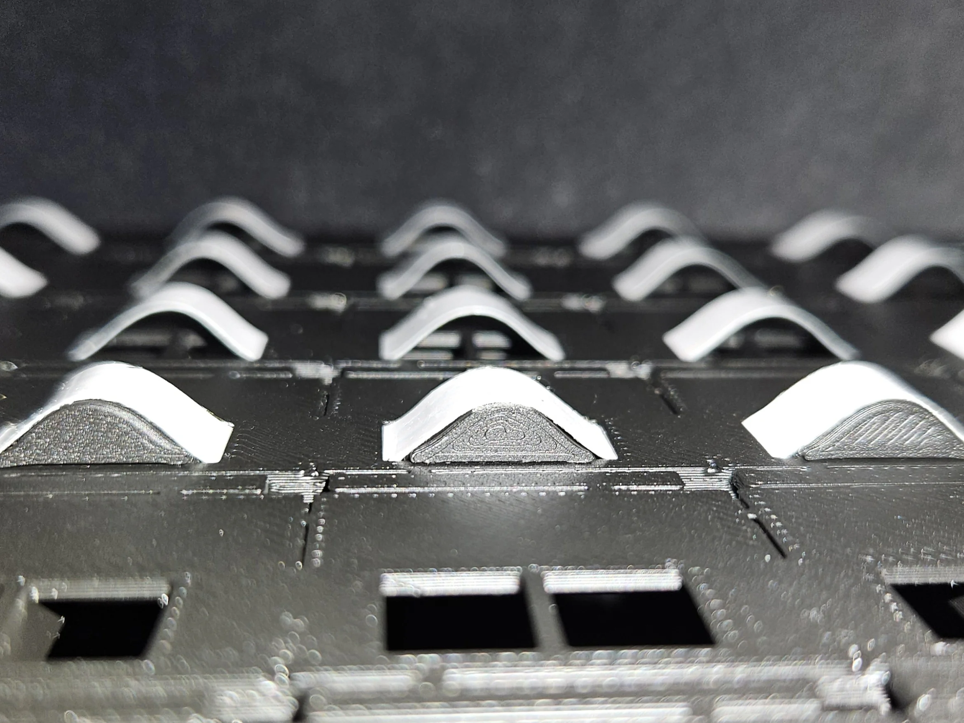
BuildGuide/12_STRIP_DONE_BACK_W_SPACER.webp
