Guignome01/OpenChess/BuildGuide/14_SENSOR_PLACE.webp

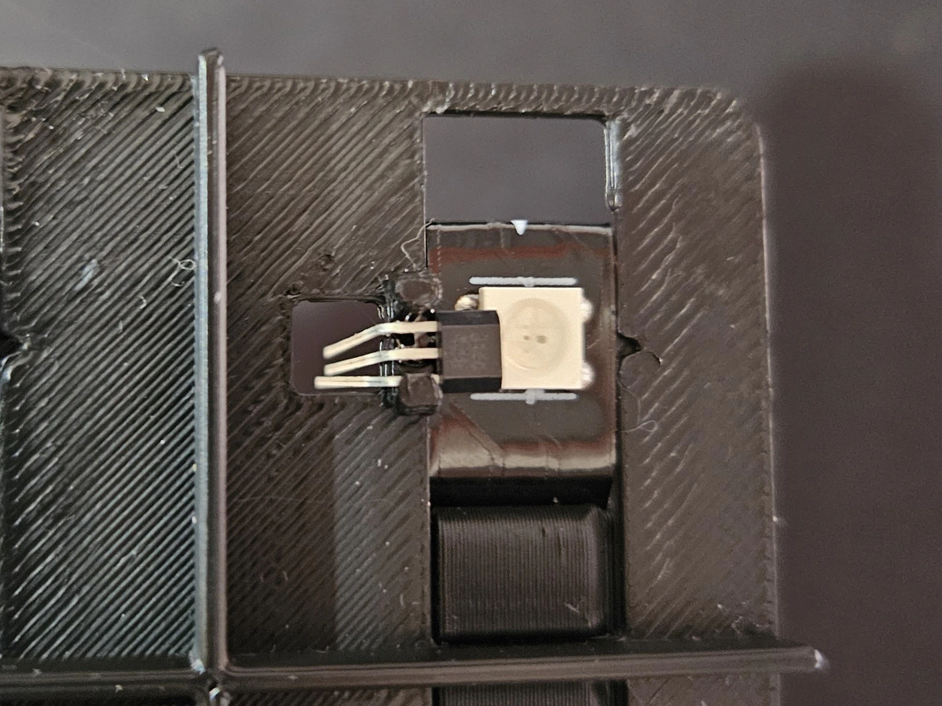
BuildGuide/14_SENSOR_PLACE.webp
