Guignome01/OpenChess/BuildGuide/15_SENSOR_PUSH.webp

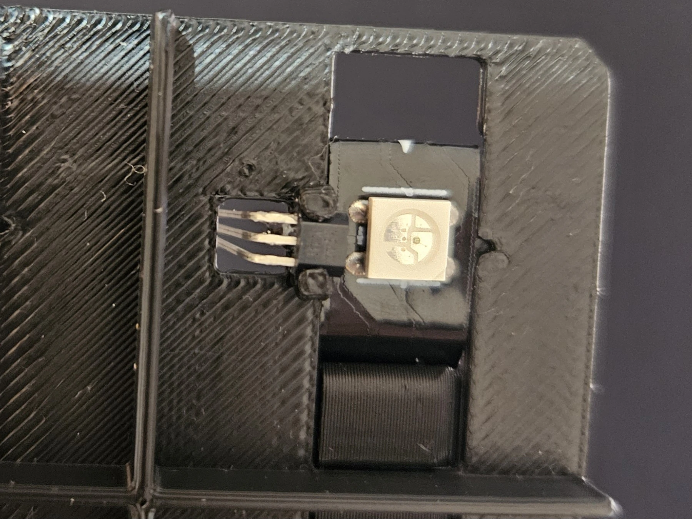
BuildGuide/15_SENSOR_PUSH.webp
