Guignome01/OpenChess/BuildGuide/16_SENSOR_MORE_GLUE.webp

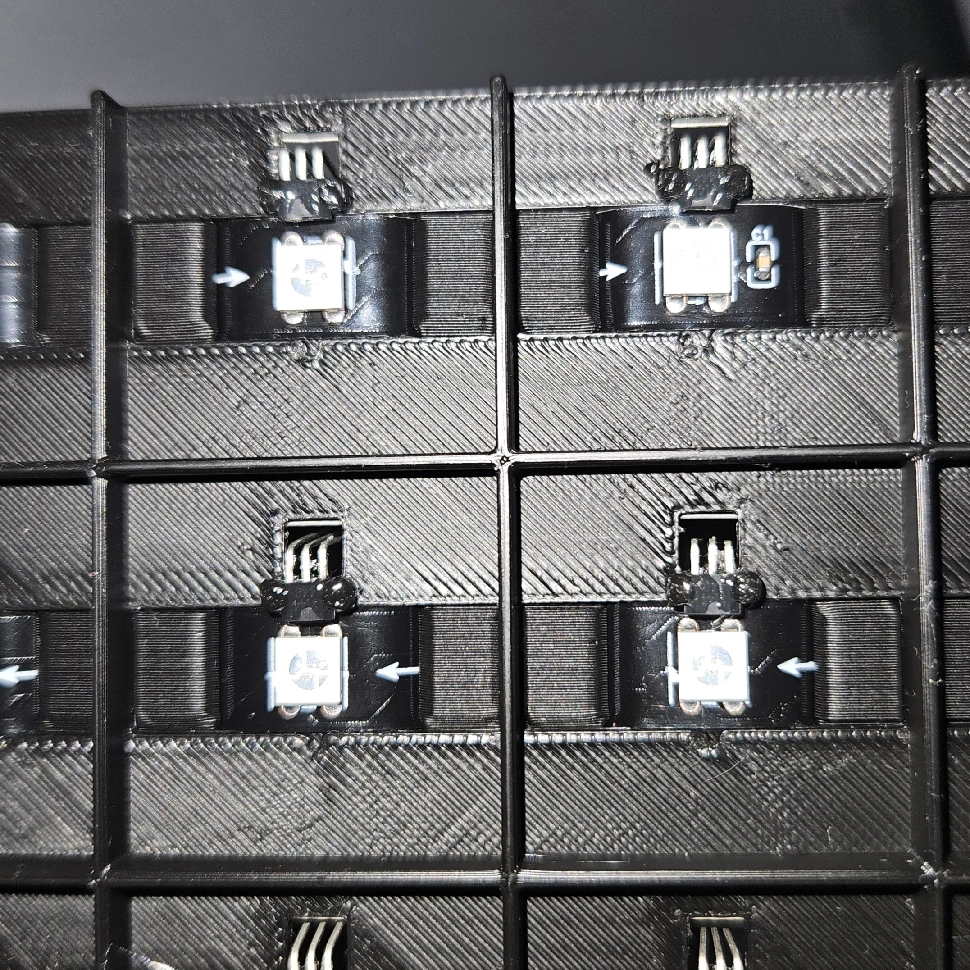
BuildGuide/16_SENSOR_MORE_GLUE.webp
