Guignome01/OpenChess/BuildGuide/17_PASS_GND_WIRES_THROUGH_GUIDES.webp

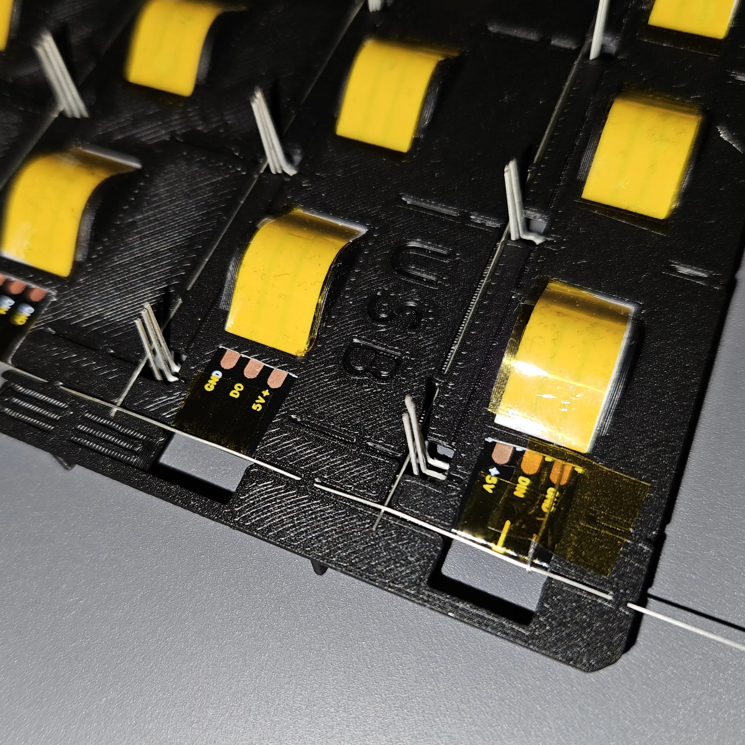
BuildGuide/17_PASS_GND_WIRES_THROUGH_GUIDES.webp
