Guignome01/OpenChess/BuildGuide/18_PASS_GND_WIRES_THROUGH_GUIDES_DONE.webp

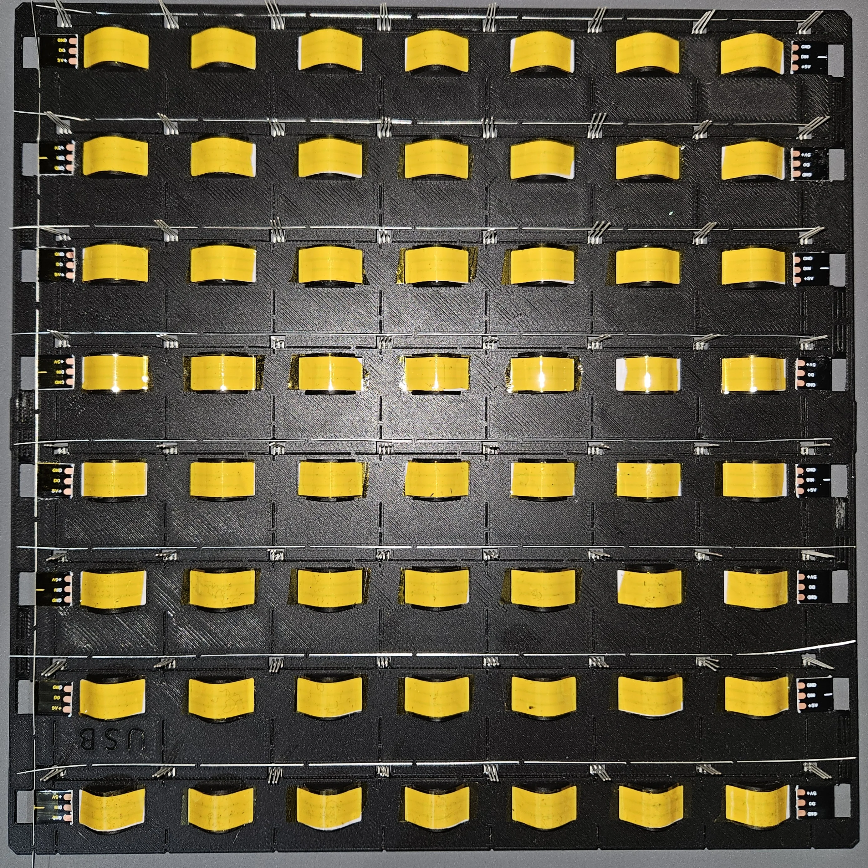
BuildGuide/18_PASS_GND_WIRES_THROUGH_GUIDES_DONE.webp
