Guignome01/OpenChess/BuildGuide/19_MOVE_SENSOR_GND_OVER_PIN.webp

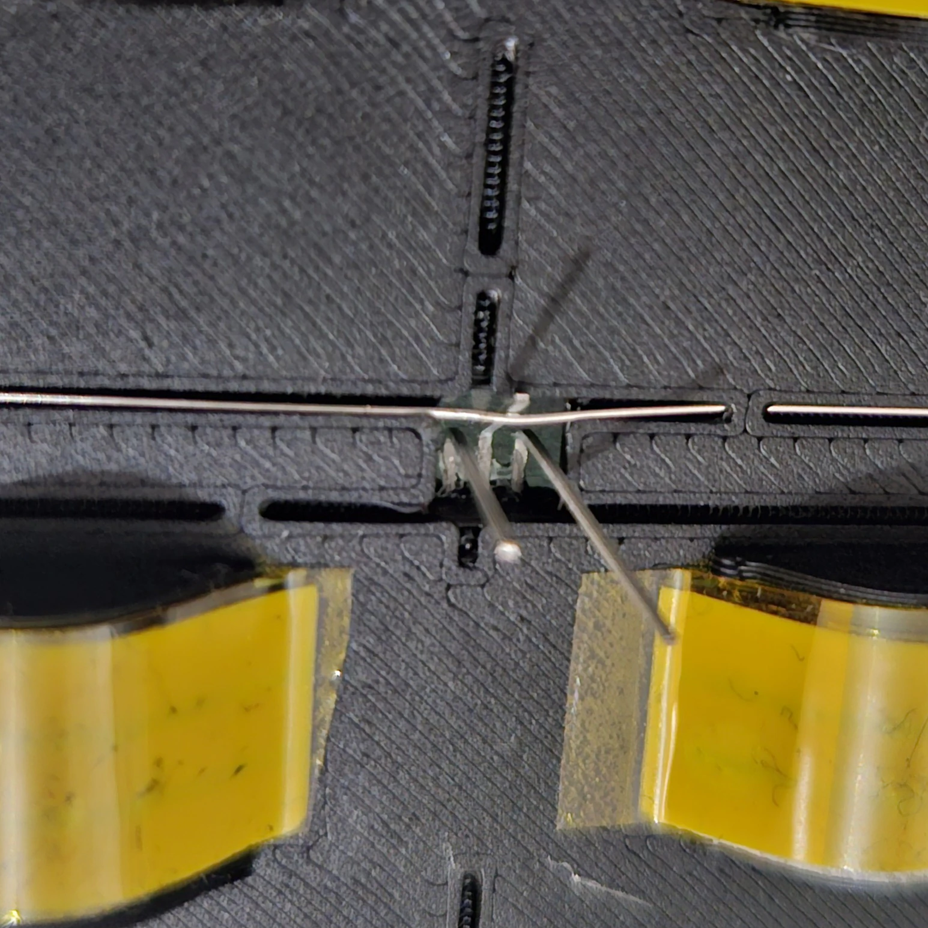
BuildGuide/19_MOVE_SENSOR_GND_OVER_PIN.webp
