Guignome01/OpenChess/BuildGuide/20_LED_STRIP_GND.webp

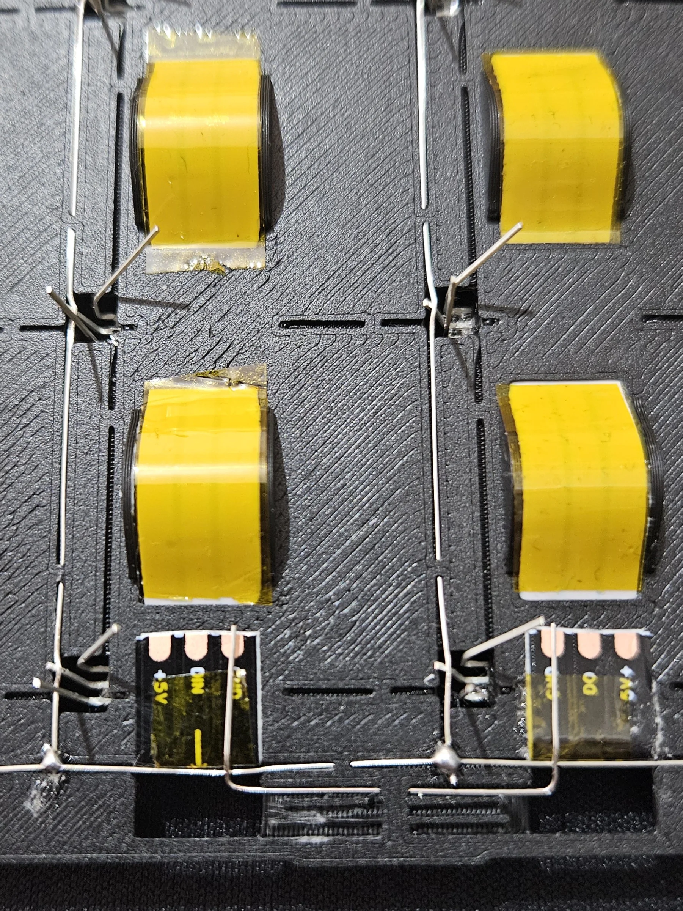
BuildGuide/20_LED_STRIP_GND.webp
