Guignome01/OpenChess/BuildGuide/21_SOLDER_LED_STRIP_GND.webp

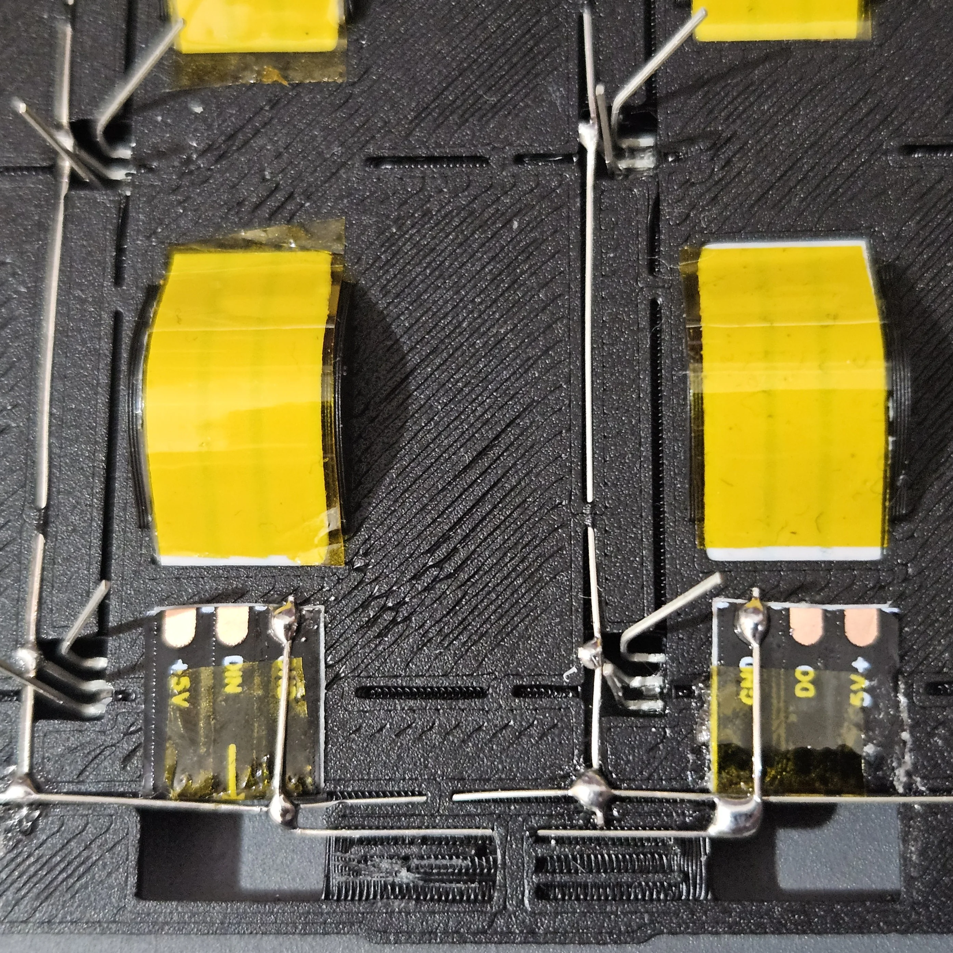
BuildGuide/21_SOLDER_LED_STRIP_GND.webp
