Guignome01/OpenChess/BuildGuide/22_SOLDER_SENSOR_GND.webp

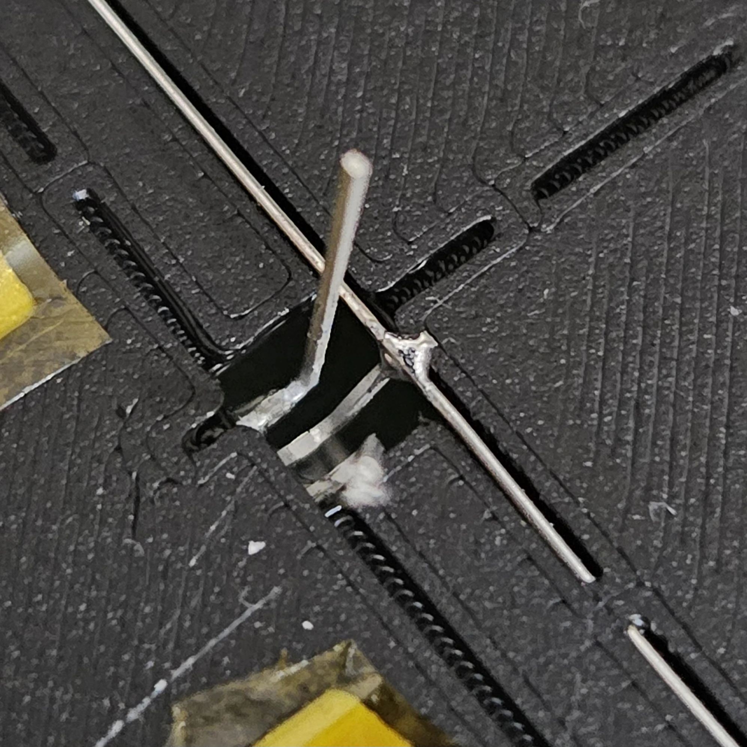
BuildGuide/22_SOLDER_SENSOR_GND.webp
