Guignome01/OpenChess/BuildGuide/23_SOLDER_GND_WIRES.webp

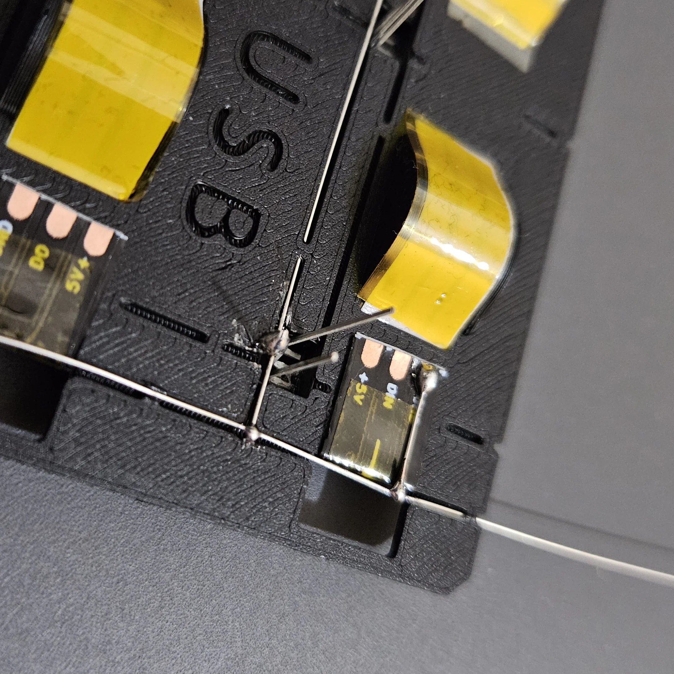
BuildGuide/23_SOLDER_GND_WIRES.webp
