Guignome01/OpenChess/BuildGuide/24_SOLDER_GND_WIRES_DONE.webp

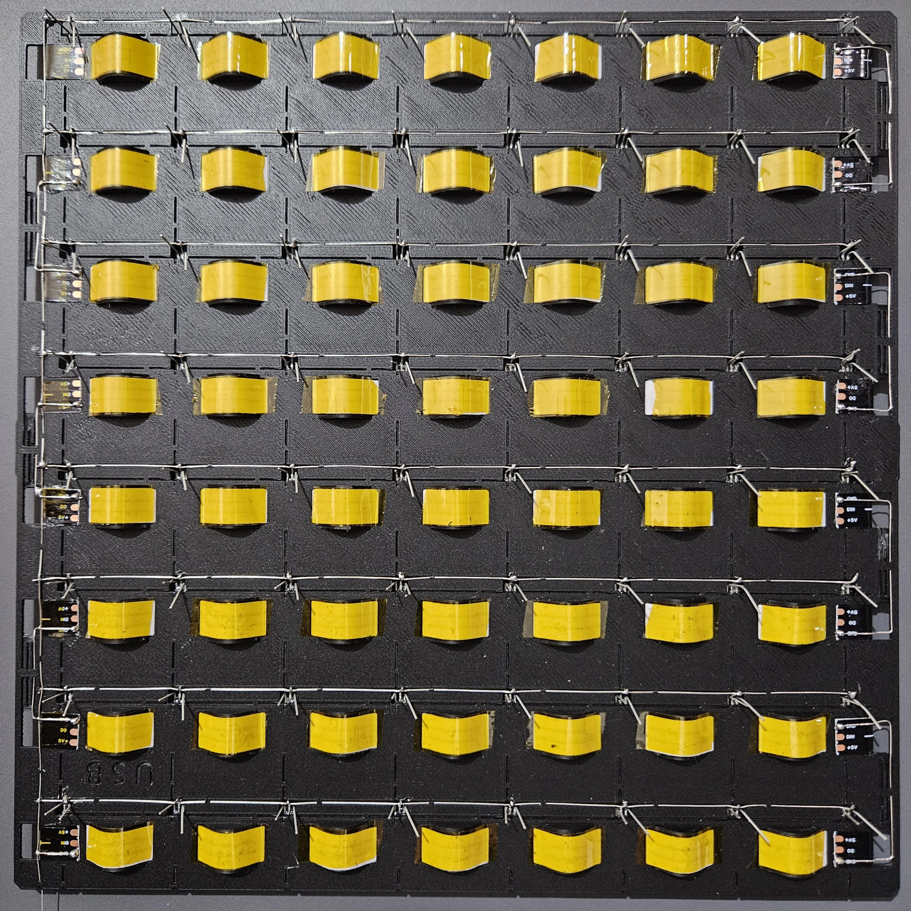
BuildGuide/24_SOLDER_GND_WIRES_DONE.webp
