Guignome01/OpenChess/BuildGuide/25_COVER_GND_WIRES.webp

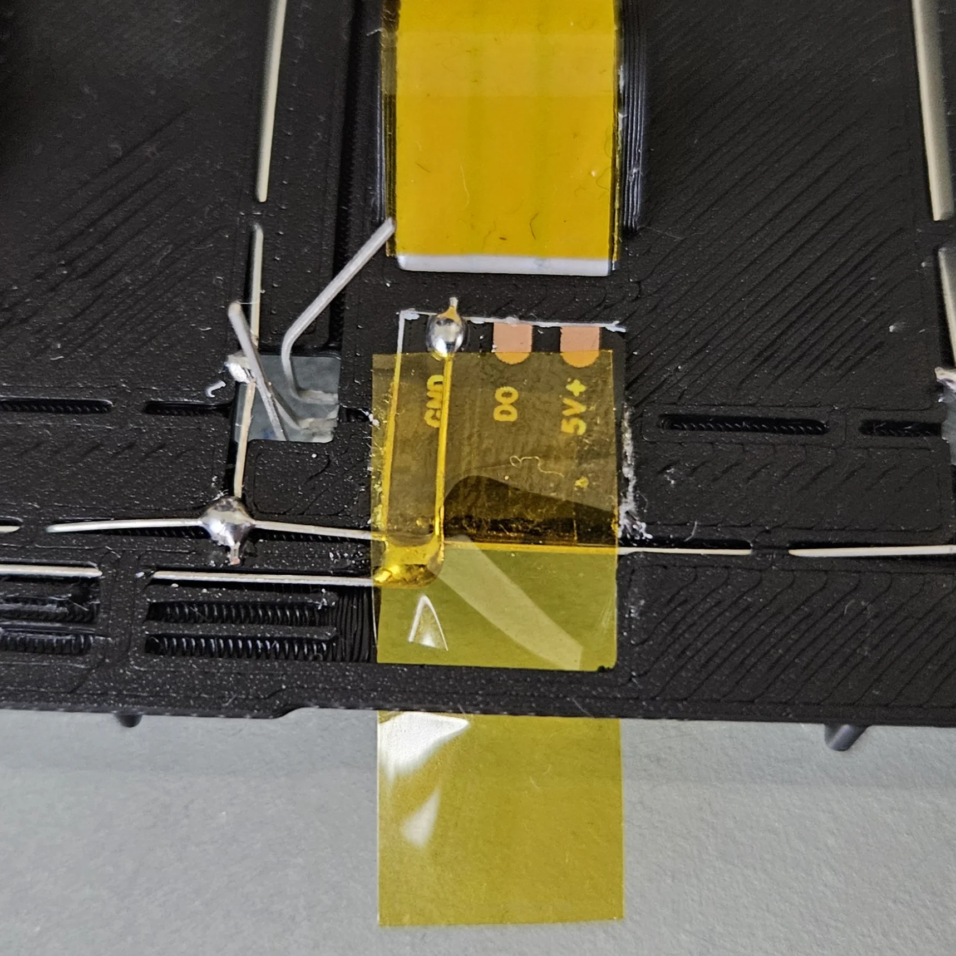
BuildGuide/25_COVER_GND_WIRES.webp
