Guignome01/OpenChess/BuildGuide/26_SOLDER_ALL_LED_STRIP_WIRES.webp

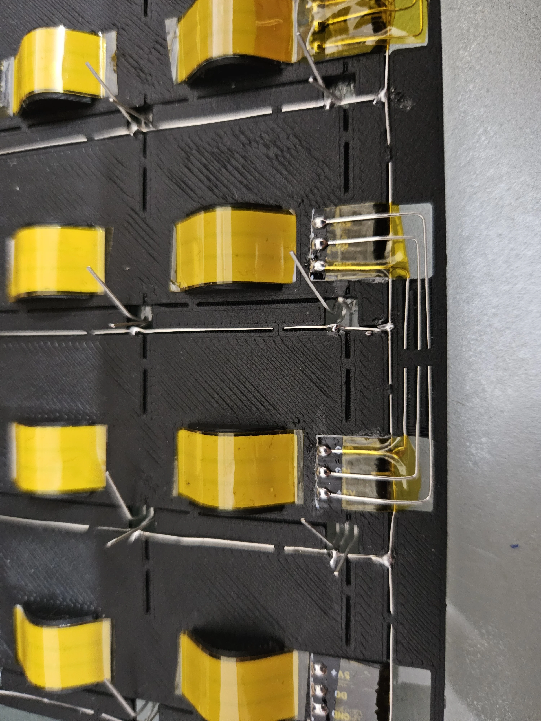
BuildGuide/26_SOLDER_ALL_LED_STRIP_WIRES.webp
