Guignome01/OpenChess/BuildGuide/27_COVER_ALL_LED_STRIP_WIRES.webp

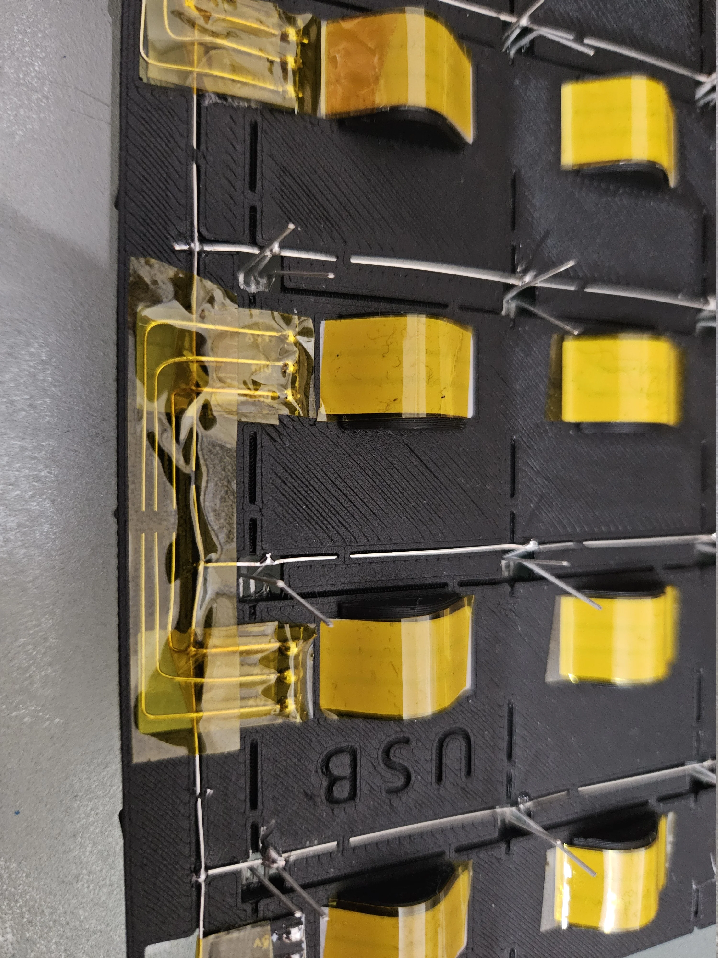
BuildGuide/27_COVER_ALL_LED_STRIP_WIRES.webp
