Guignome01/OpenChess/BuildGuide/28_PASS_ROW_WIRES.webp

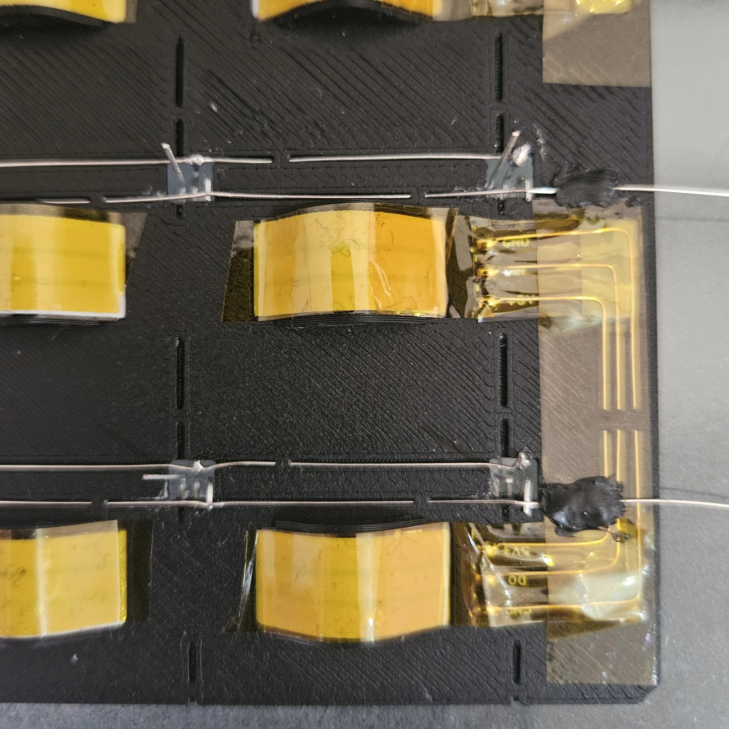
BuildGuide/28_PASS_ROW_WIRES.webp
