Guignome01/OpenChess/BuildGuide/29_SOLDER_ROW_WIRES.webp

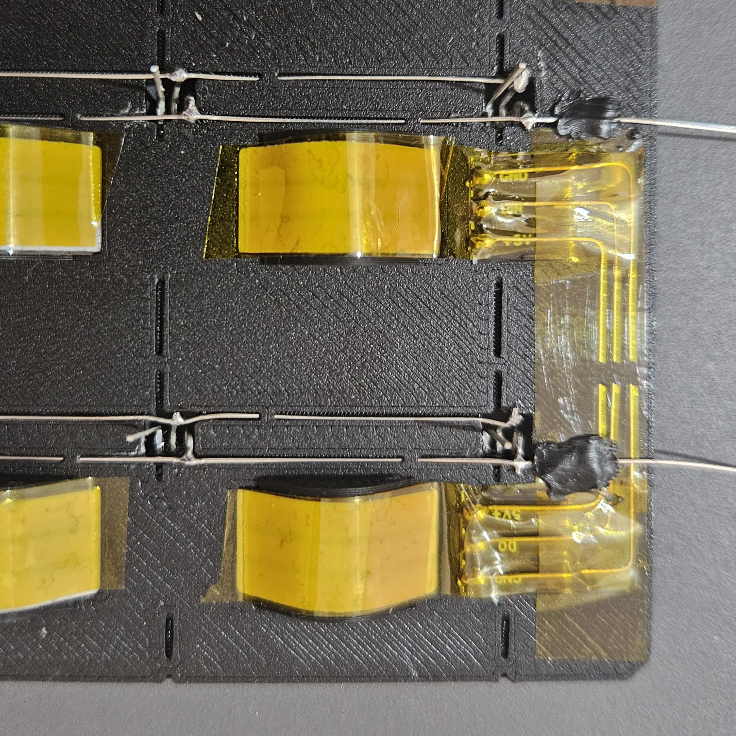
BuildGuide/29_SOLDER_ROW_WIRES.webp
