Guignome01/OpenChess/BuildGuide/30_SOLDER_ROW_WIRES_DONE.webp

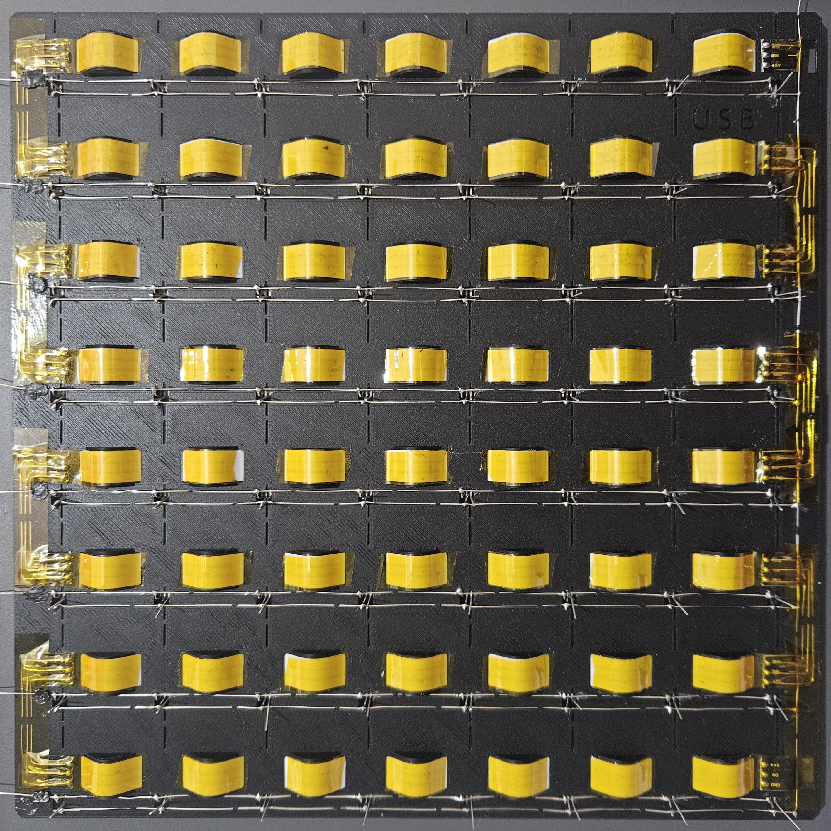
BuildGuide/30_SOLDER_ROW_WIRES_DONE.webp
