Guignome01/OpenChess/BuildGuide/31_PASS_A3144_5V_WIRES_1ST_METHOD.webp

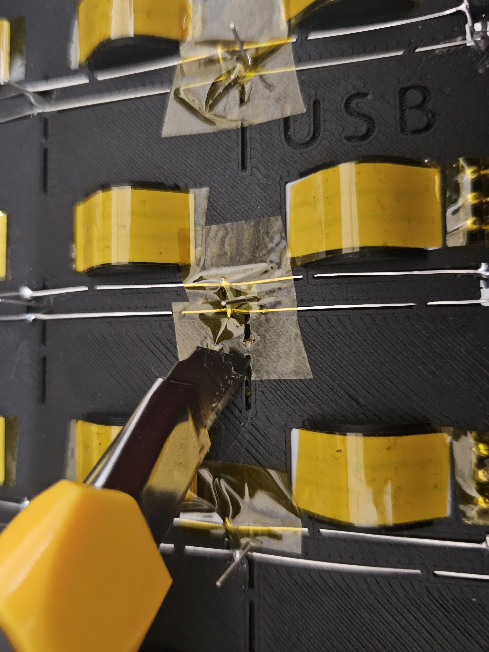
BuildGuide/31_PASS_A3144_5V_WIRES_1ST_METHOD.webp
