Guignome01/OpenChess/BuildGuide/32_PASS_A3144_5V_WIRES_1ST_METHOD_DONE.webp

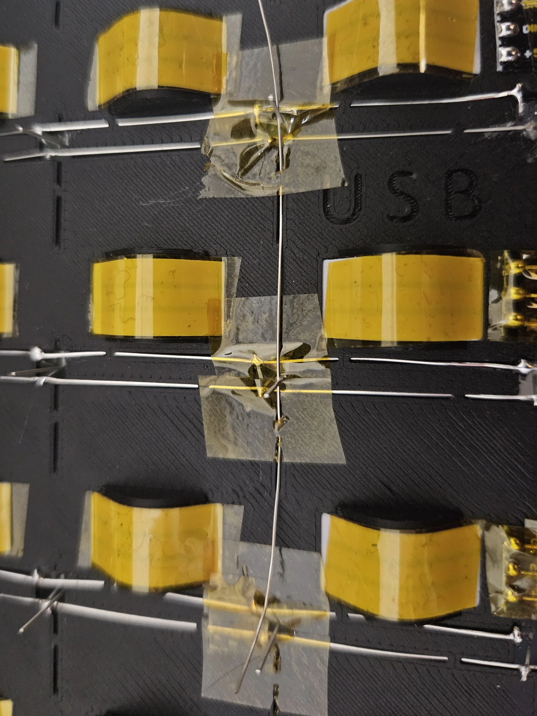
BuildGuide/32_PASS_A3144_5V_WIRES_1ST_METHOD_DONE.webp
