Guignome01/OpenChess/BuildGuide/33_PASS_A3144_5V_WIRES_2ND_METHOD.webp

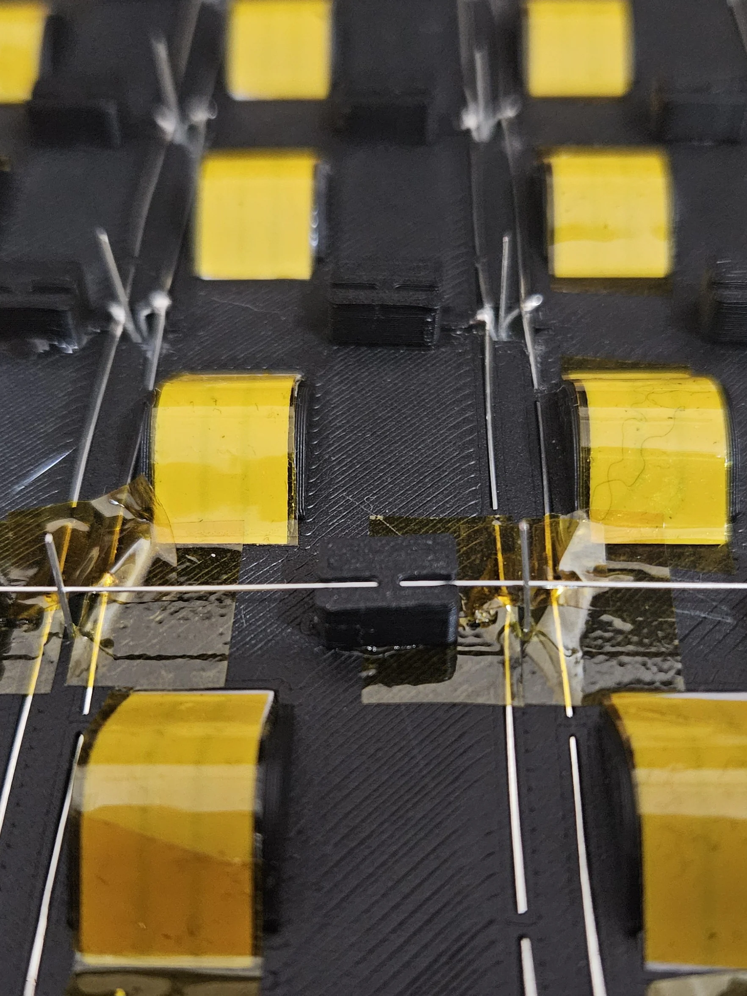
BuildGuide/33_PASS_A3144_5V_WIRES_2ND_METHOD.webp
