Guignome01/OpenChess/BuildGuide/34_CUT_EXTRA_PIN_LENGTH.webp

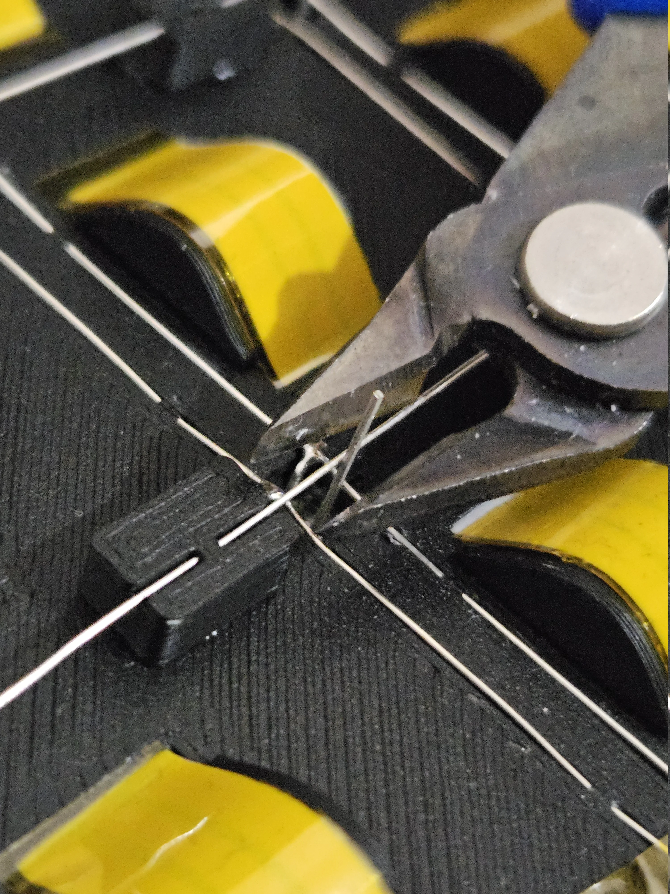
BuildGuide/34_CUT_EXTRA_PIN_LENGTH.webp
