Guignome01/OpenChess/BuildGuide/35_CUT_EXTRA_PIN_LENGTH_DONE.webp

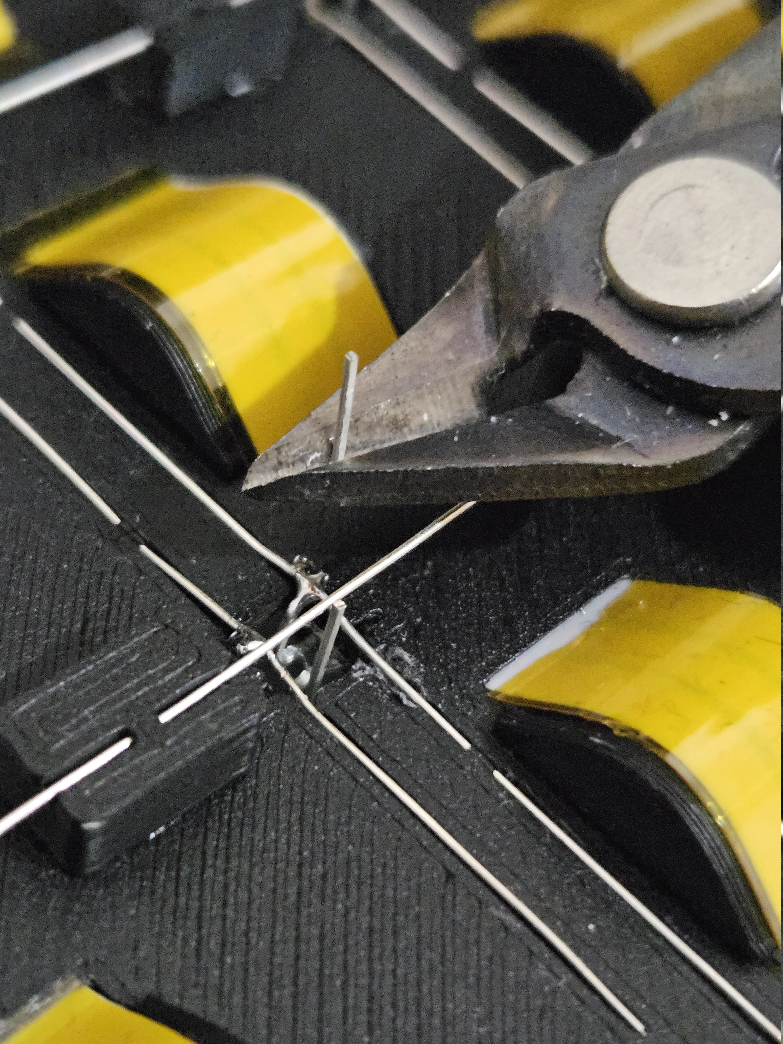
BuildGuide/35_CUT_EXTRA_PIN_LENGTH_DONE.webp
