Guignome01/OpenChess/BuildGuide/36_SOLDER_A3144_5V.webp

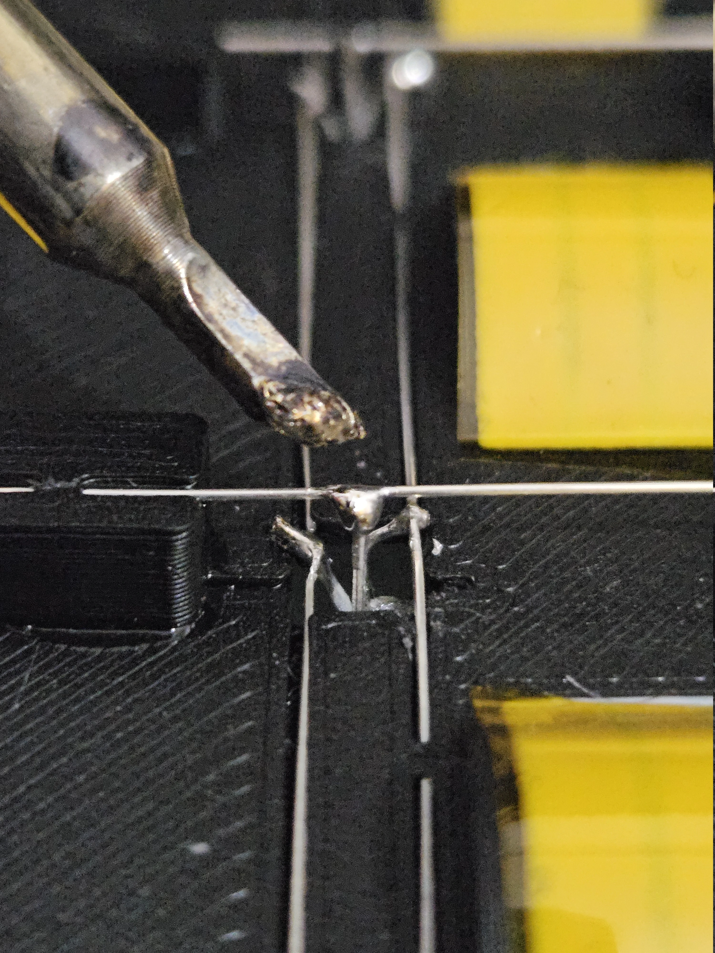
BuildGuide/36_SOLDER_A3144_5V.webp
