Guignome01/OpenChess/BuildGuide/38_ALL_WIRES_SOLDERED_PERSPECTIVE2.webp

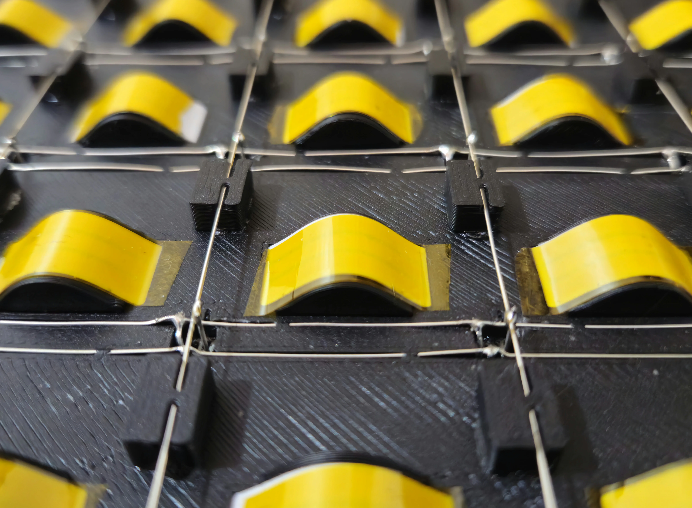
BuildGuide/38_ALL_WIRES_SOLDERED_PERSPECTIVE2.webp
