Guignome01/OpenChess/BuildGuide/40_PLASTIC_PCB_DONE_FRONT.webp

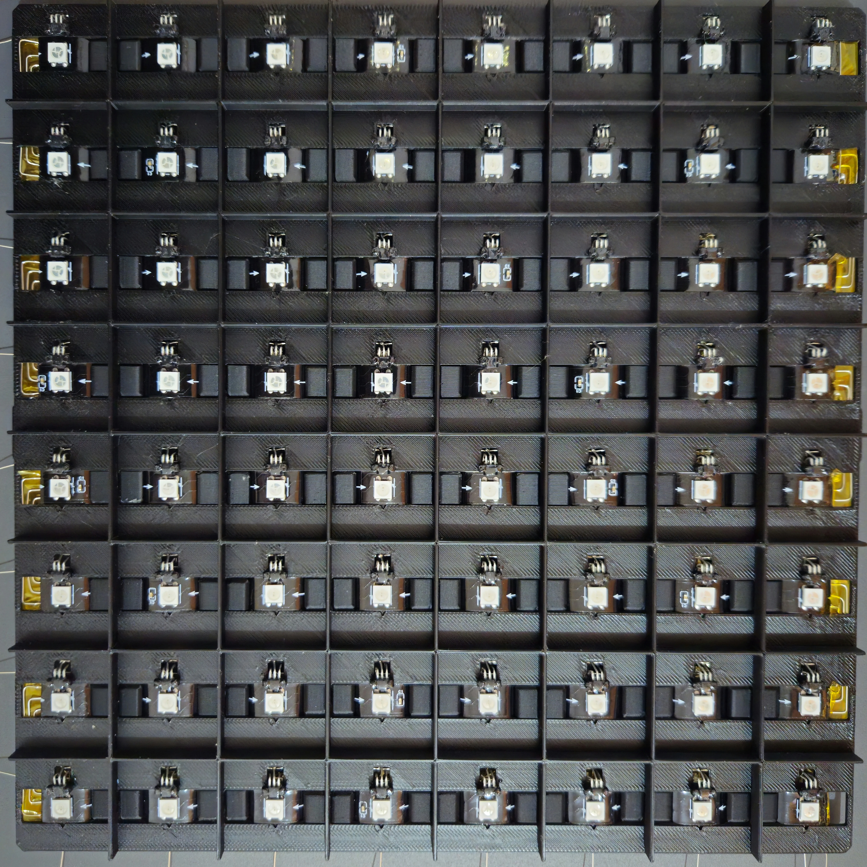
BuildGuide/40_PLASTIC_PCB_DONE_FRONT.webp
