Guignome01/OpenChess/BuildGuide/41_IRON_DISC_SIZE.webp

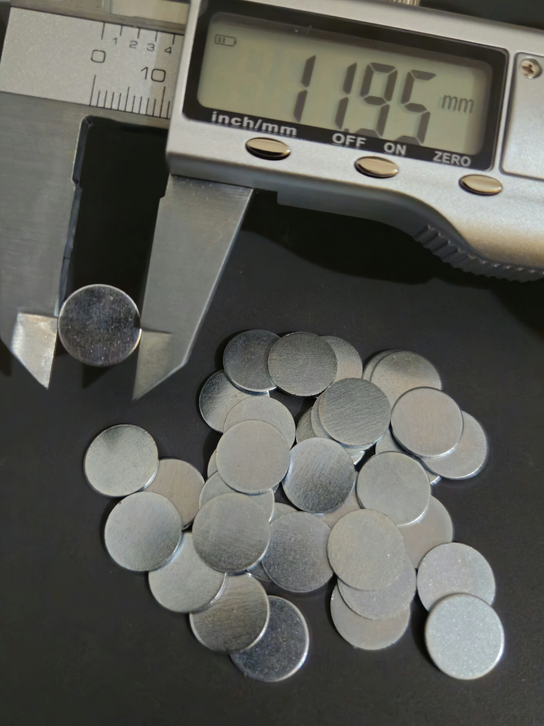
BuildGuide/41_IRON_DISC_SIZE.webp
