Guignome01/OpenChess/BuildGuide/42_IRON_DISC_3D_PRINT_SIZE.webp

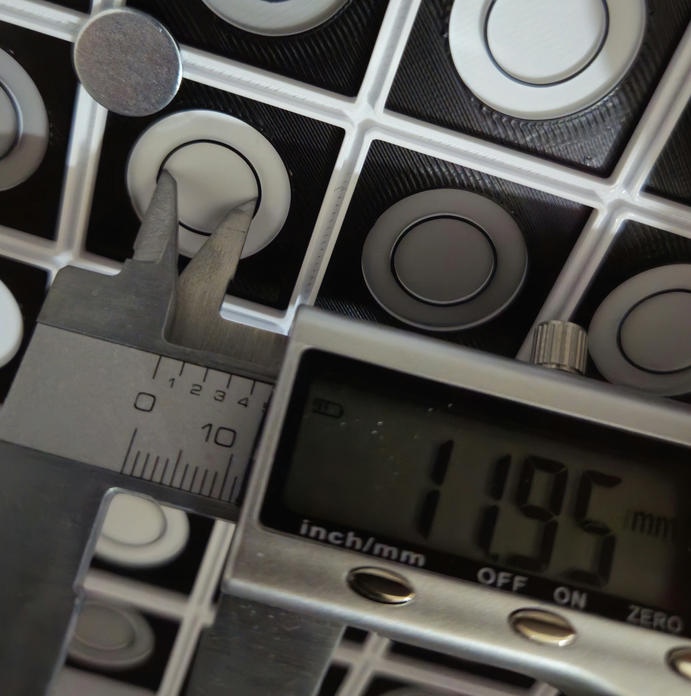
BuildGuide/42_IRON_DISC_3D_PRINT_SIZE.webp
