Guignome01/OpenChess/BuildGuide/43_GLUE_IRON_DISC.webp

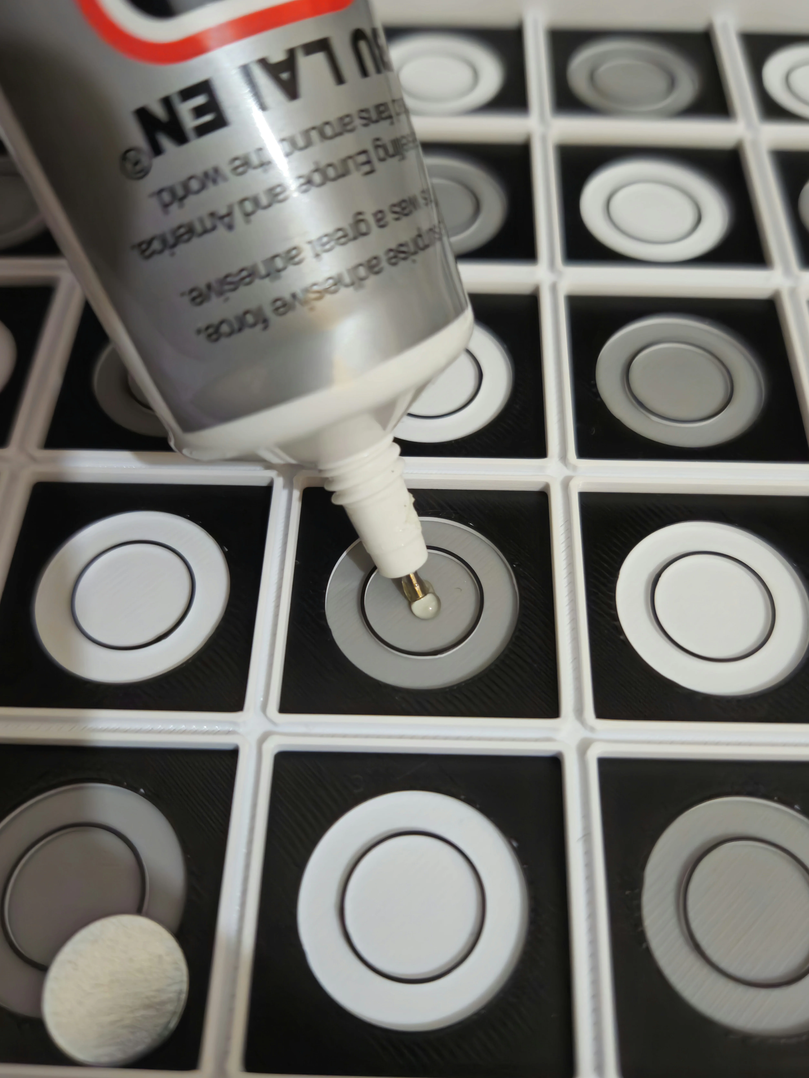
BuildGuide/43_GLUE_IRON_DISC.webp
