Guignome01/OpenChess/BuildGuide/44_GLUE_IRON_DISC_DONE.webp

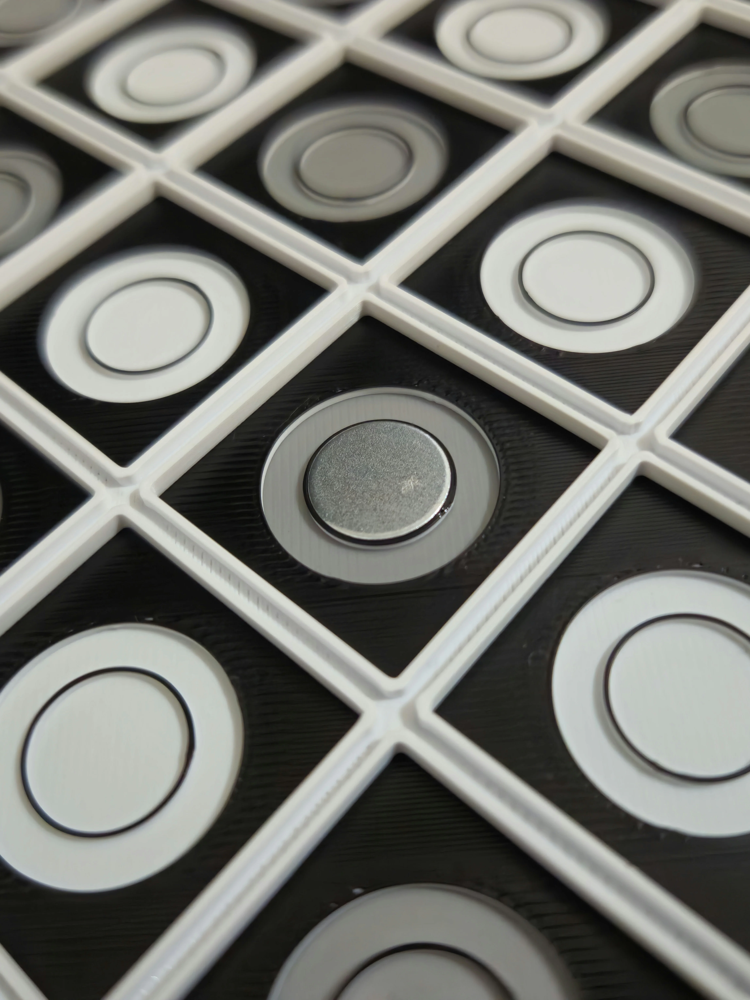
BuildGuide/44_GLUE_IRON_DISC_DONE.webp
