Guignome01/OpenChess/BuildGuide/45_GLUE_IRON_DISC_DONE_BACK.webp

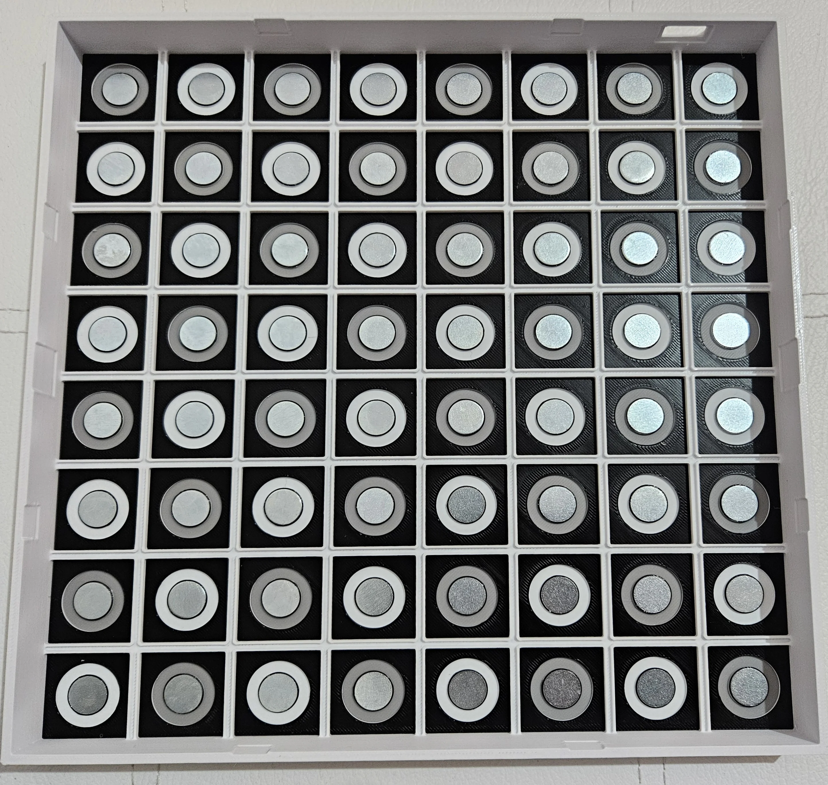
BuildGuide/45_GLUE_IRON_DISC_DONE_BACK.webp
