Guignome01/OpenChess/BuildGuide/48_BOARD_DONE_FRONT.webp

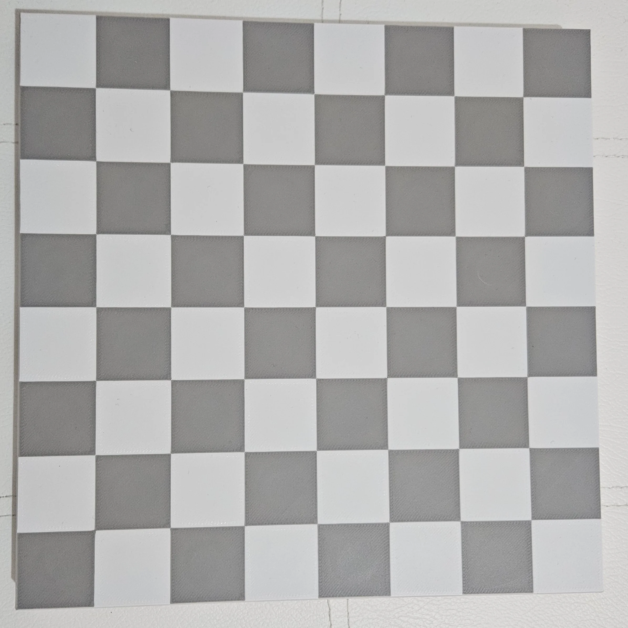
BuildGuide/48_BOARD_DONE_FRONT.webp
