Guignome01/OpenChess/BuildGuide/49_PCB_TAPE.webp

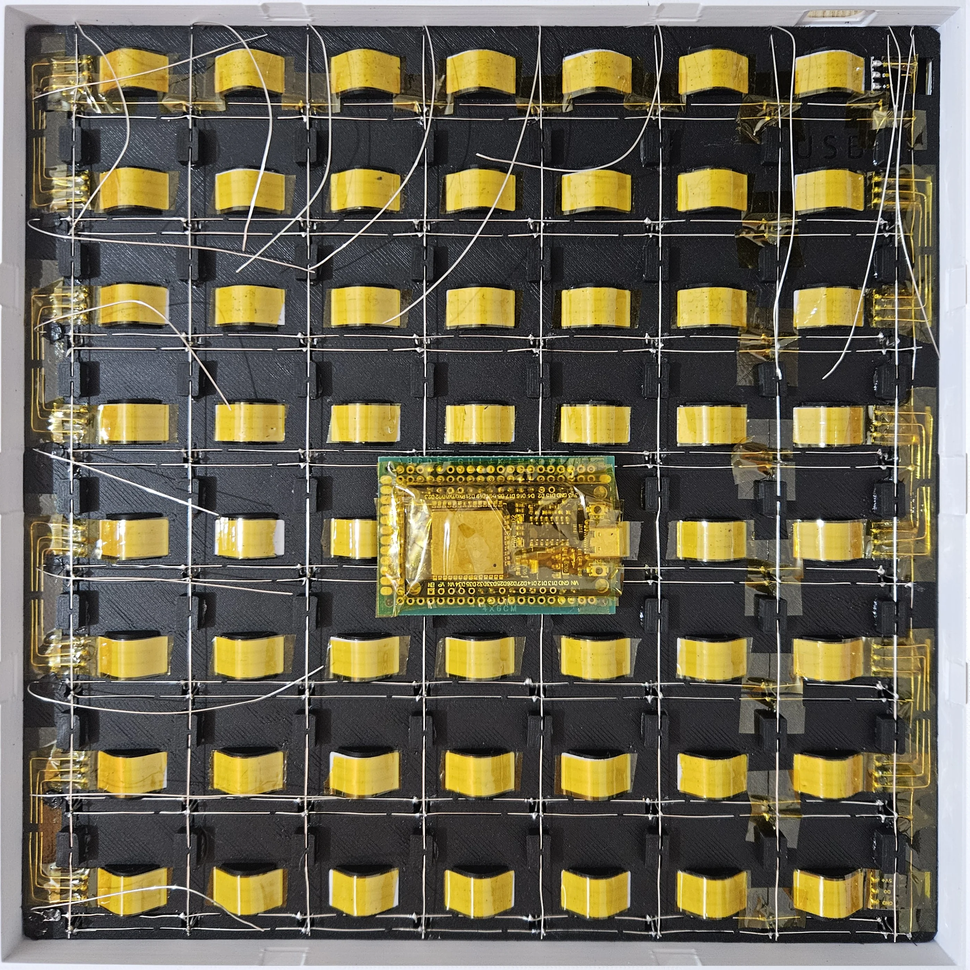
BuildGuide/49_PCB_TAPE.webp
