Guignome01/OpenChess/BuildGuide/50_PCB_PLACEMENT.webp

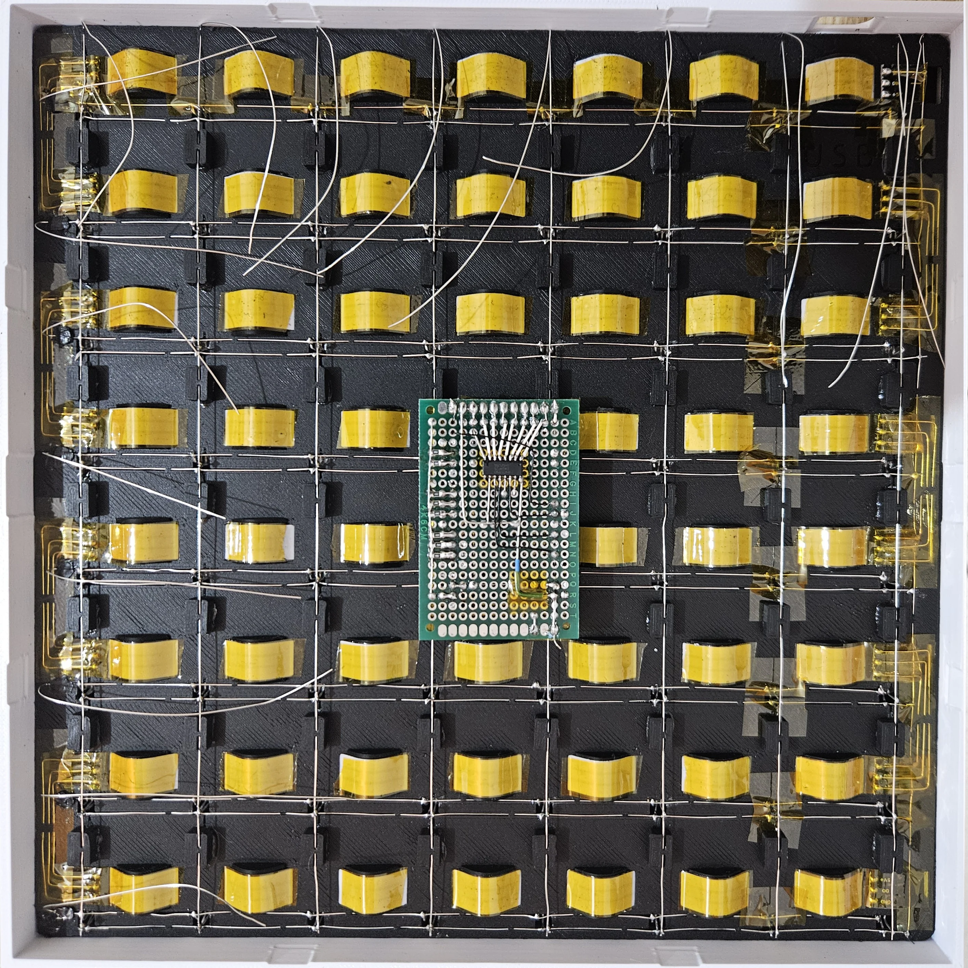
BuildGuide/50_PCB_PLACEMENT.webp
