Guignome01/OpenChess/BuildGuide/51_PCB_SOLDER_ROWS_N_COLS.webp

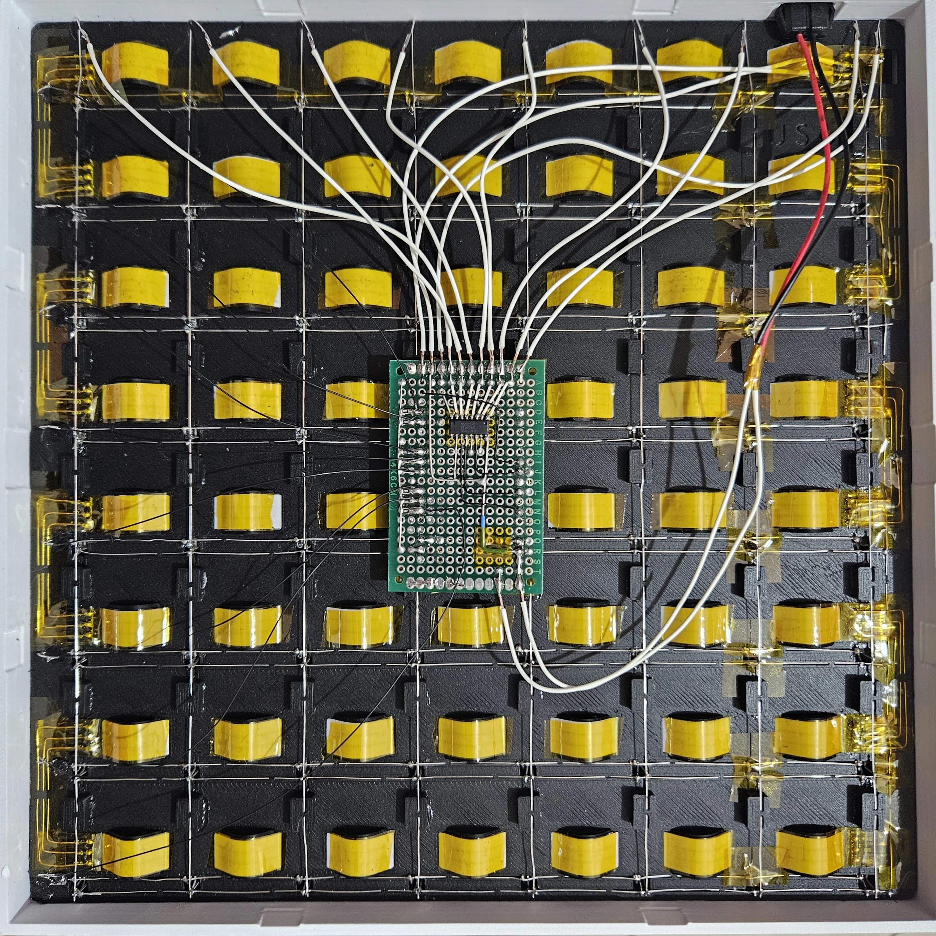
BuildGuide/51_PCB_SOLDER_ROWS_N_COLS.webp
