Guignome01/OpenChess/BuildGuide/52_PCB_SOLDER_ROWS_COLS_CLOSEUP.webp

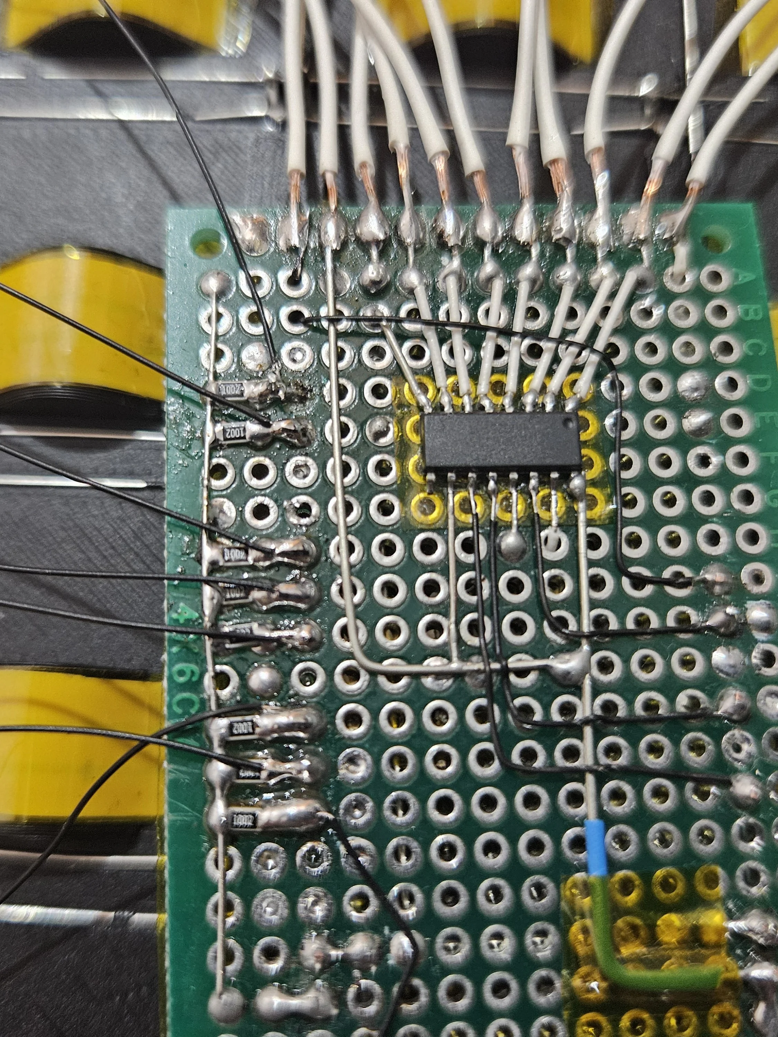
BuildGuide/52_PCB_SOLDER_ROWS_COLS_CLOSEUP.webp
