Guignome01/OpenChess/BuildGuide/OpenChess - Plastic PCB (Bot config).webp

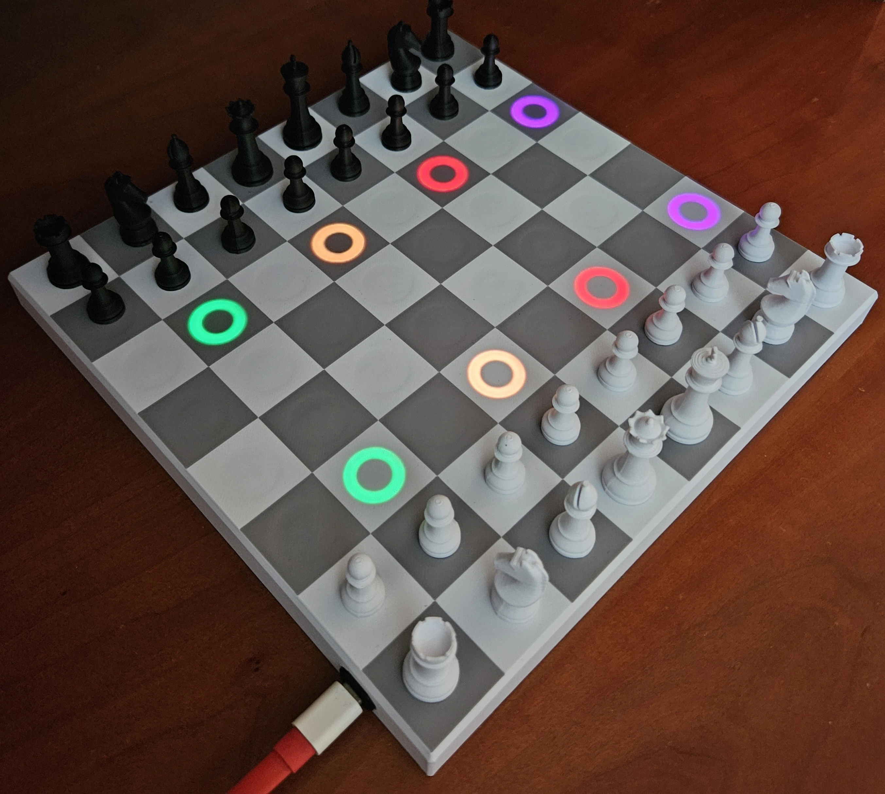
BuildGuide/OpenChess - Plastic PCB (Bot config).webp
