Guignome01/OpenChess/BuildGuide/OpenChess - Plastic PCB (move 1).webp

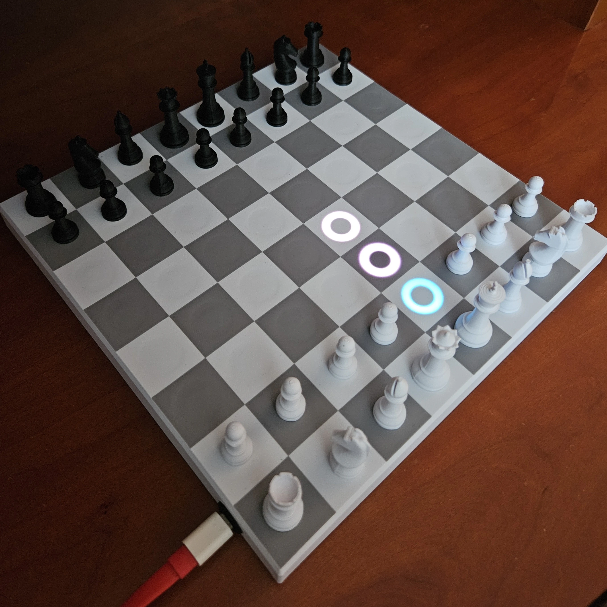
BuildGuide/OpenChess - Plastic PCB (move 1).webp
