Guignome01/OpenChess/BuildGuide/OpenChess - Plastic PCB (move 2).webp

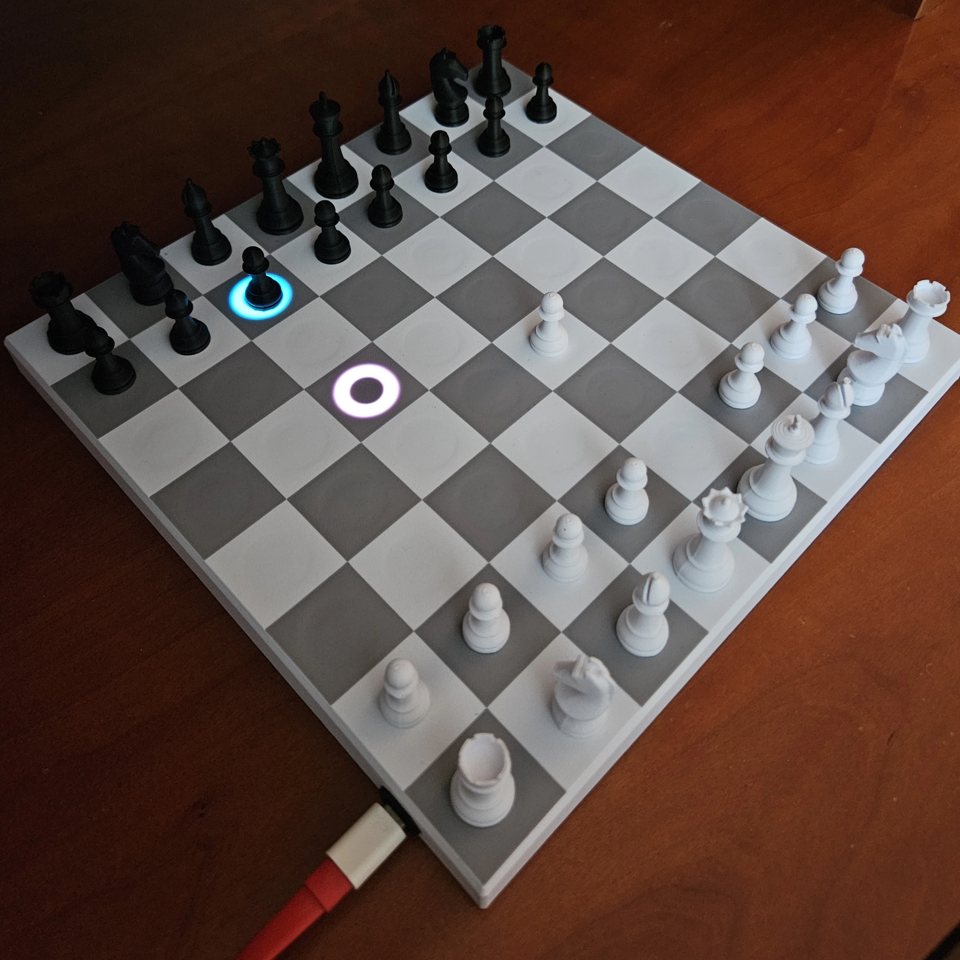
BuildGuide/OpenChess - Plastic PCB (move 2).webp
