Guignome01/OpenChess/BuildGuide/OpenChess - Plastic PCB (move 3).webp

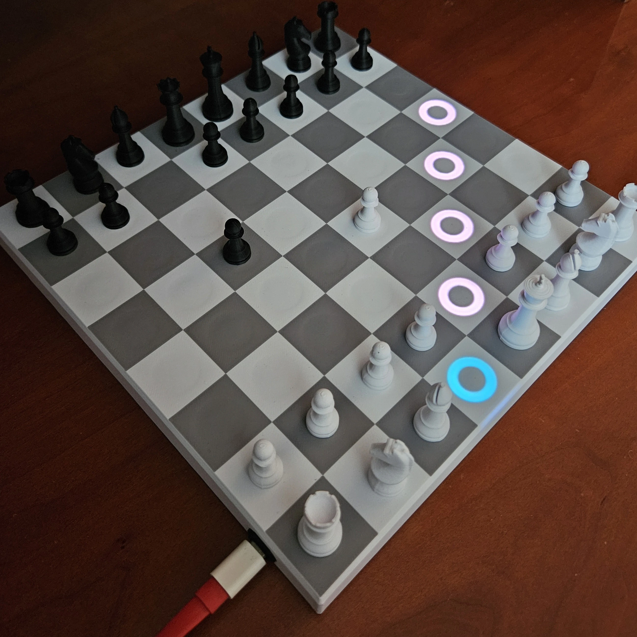
BuildGuide/OpenChess - Plastic PCB (move 3).webp
