Guignome01/OpenChess/BuildGuide/47_BOARD_DONE_FRONT_LIGHT_TEST.webp

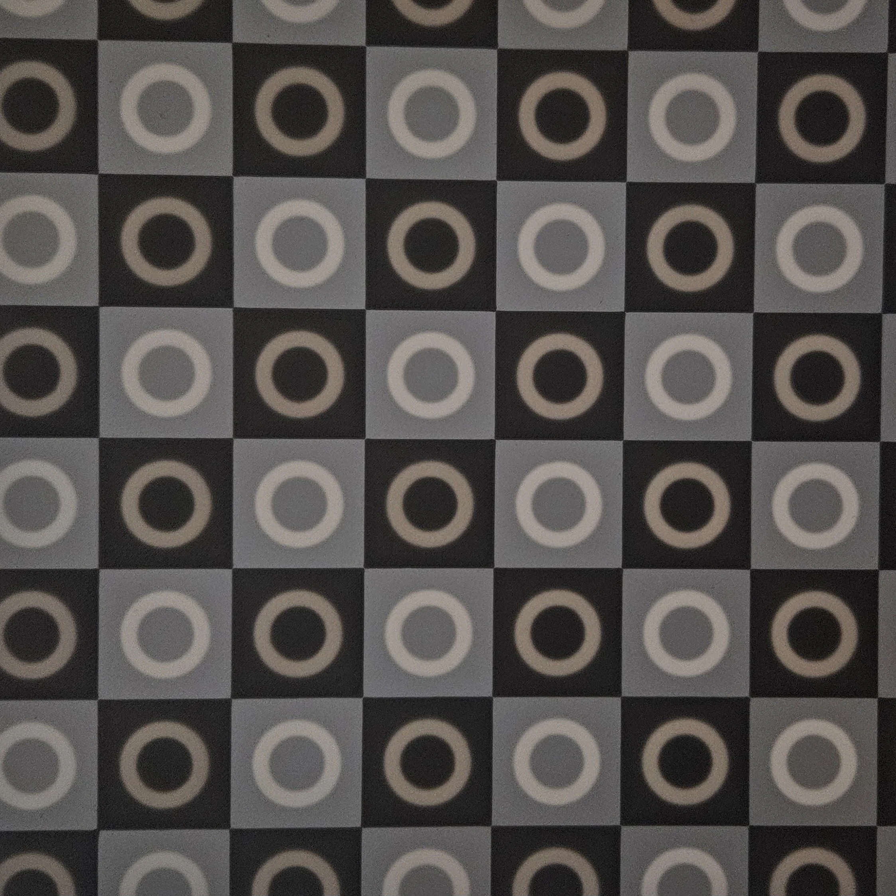
BuildGuide/47_BOARD_DONE_FRONT_LIGHT_TEST.webp
