Guignome01/OpenChess/src/chess_lichess.h

#ifndef CHESS_LICHESS_H
#define CHESS_LICHESS_H

#include "chess_bot.h"
#include "lichess_api.h"
#include <atomic>

// Lichess game configuration
struct LichessConfig {
  String apiToken;
};

class ChessLichess : public ChessBot {
 private:
  LichessConfig lichessConfig;
  String currentGameId;
  char myColor; // 'w' or 'b' - the color we play as

  // Last known state from Lichess
  String lastKnownMoves;
  // Track last move we sent to avoid processing it as remote move
  String lastSentMove;

  // Polling state
  unsigned long lastPollTime;
  static const unsigned long POLL_INTERVAL_MS = 500;

  // Animation stop flag for remote turn thinking animation
  std::atomic<bool>* stopAnimation;

  // Game flow
  void waitForLichessGame();
  void syncBoardWithLichess(const LichessGameState& state);
  void sendMoveToLichess(int fromRow, int fromCol, int toRow, int toCol, char promotion = ' ');

 public:
  ChessLichess(BoardDriver* bd, ChessEngine* ce, WiFiManagerESP32* wm, LichessConfig cfg);
  void begin() override;
  void update() override;

 protected:
  bool handleResign(char resignColor) override;
};

#endif // CHESS_LICHESS_H
