Guignome01/OpenChess/src/arduino_secrets.h

#ifndef ARDUINO_SECRETS_H
#define ARDUINO_SECRETS_H

// WiFi Network Credentials
#define SECRET_SSID "YOUR_SSID"
#define SECRET_PASS "YOUR_PASSWORD"

// Stockfish API Settings
#define STOCKFISH_API_URL "stockfish.online"
#define STOCKFISH_API_PATH "/api/s/v2.php"
#define STOCKFISH_API_PORT 443 // HTTPS port

#endif
