Guignome01/OpenChess/(commit log)

2025-11-20 Vibe-coded support for ESP32
    Warning this adds 99% vibe-codded support for ESP32. Use with caution.
    Cursor in agent mode is used.
2025-11-20 Set colors for board setup to show correct orrentation of the board
    [board_driver.cpp]
2026-01-11 Initial PlatformIO refactor
    Sensor_Test.cpp: Simplified row/column scanning logic and shift register load functions. New array to map row/col to pixel index. Replaced ESP32 unusable GPIO. Added different brightness for light and dark squares. Replaced RGBW with RGB NeoPixel config to work with the much cheaper WS2812B LEDs.
    board_driver.cpp: Renamed shift register pins, replaced NEO_GRBW with GRB
    [Sensor_Test.cpp, arduino_secrets.h, board_driver.cpp, main.cpp, stockfish_settings.h, wifi_manager.cpp, wifi_manager.h]
2026-01-11 board_driver: fix row/col pins and pixel index mapping
    [Sensor_Test.cpp, board_driver.cpp]
2026-01-11 fix wifi connection attempt visualization
    flash the leds for each attempt, not just once
2026-01-13 new clang-format, new stockfish api
    the existing stockfish api response parsing is terrible, needs to be replaced
    [stockfish_api.cpp]
2026-01-14 Consolidate bot modes into single configurable MODE_BOT
    - Merge BLACK_BOT_MEDIUM and WHITE_BOT_MEDIUM into MODE_BOT with difficulty/color selection
    - Remove BotDifficulty enum, use StockfishSettings directly
    - Add BotConfig struct (stockfishSettings + playerIsWhite) throughout codebase
    - Implement physical board and web UI configuration interfaces
    - Fix Medium difficulty: depth 6 → 10
    [main.cpp, stockfish_api.cpp, stockfish_settings.h, wifi_manager_esp32.cpp, wifi_manager_esp32.h]
2026-01-15 fix castling led flicker + wrong move printed in serial monitor
    [chess_common.cpp, chess_common.h]
2026-01-22 prevent accidental bot config selection
    [main.cpp]
2026-01-22 show gamemode selection on gameover
    can now start a new game after checkmate/stealmate without requiring a power cycle. Thanks to previous commit a gamemode won't be accidentally selected if some pieces are on the selection squares
    [chess_game.h, main.cpp]
2026-01-22 En passant captures + FEN
    - LedColor refactor
    - En passant player capture + correct FEN generation and parsing
    [board_driver.cpp, chess_game.cpp, led_colors.h, main.cpp]
2026-01-23 new board view/edit w/ drag n drop+FEN
    thx to the open source project: https://chessboardjs.com
2026-01-28 flip, focus, settings, custom board themes, sound
    - board flip and focus (zoom) buttons
    - settings popup for with notation/sound toggles, board square color personalization and custom piece themes
    - capture and move sounds (from lichess)
    - lichess game: show simple piece evaluation in webUI
    - use esp32async libraries instead of old me-no-dev
2026-01-28 original PCB pins image, update README, typos
    If anyone wants to use the original PCB and swap the discontinued Arduino Connect with an ESP32, those are the pins
2026-01-29 lichess move send retry on fail
    [chess_lichess.h]
2026-02-02 Force LedRGB usage everywhere
    all colors shown on the board are defined in led_colors.h, this makes it easier to change a color without having to go look for it who knows where with who knows what RGB values. This commit makes it impossible to call any led function with arbitrary RGB values, must define a color first
2026-02-05 more calibration serial logs
2026-02-12 Refactor promotion and misc bug fixes
    Renames promotedPiece -> promotion across ChessGame/ChessLichess, fixes printf formatting for promotion output. Fixes WiFiManager logic: use OR when comparing new SSID/password to current ones and corrects the Lichess mode index check. Fix hasAnyLegalMove() performance: calling wouldMoveLeaveKingInCheck() on moves that never do leave the king in check.
    [chess_game.cpp, chess_game.h, chess_lichess.h, wifi_manager_esp32.cpp]
2026-02-12 more refactor
    These changes improve const-correctness, centralize UCI conversion, reduce duplicated parsing logic, stabilize mode lifecycle, and standardize JSON output generation.
    [board_driver.cpp, lichess_api.cpp, lichess_api.h, main.cpp, stockfish_settings.h, wifi_manager_esp32.cpp, wifi_manager_esp32.h]
2026-02-16 Fix LED animation glitches during bot thinking, castling, and piece movement
    - Add LedGuard RAII pattern for safe LED mutex management
    - Add stopAndWaitForAnimation() for clean cancellation of animations
    - Add waitForAnimationQueueDrain() queue barrier to prevent stale animations from overwriting highlights
    - Protect all direct LED writes (tryPlayerMove, applyCastling, setBrightness, setDimMultiplier) with mutex
    - Switch from Adafruit NeoPixel (RMT) to NeoPixelBus (I2S DMA) to eliminate flicker caused by requests
    [board_driver.cpp, chess_game.cpp, main.cpp]
2026-02-17 Add reusable board menu system with stack-based navigation
    Replace ad-hoc game selection and bot config logic with reusable GUI primitives for the 8x8 LED board.
    - `BoardMenu`: consistent two-phase debounce, blink feedback, orientation flipping, configurable back button
    - `MenuNavigator`: fixed-depth stack with auto back-button handling and parent re-display
    - `boardConfirm()`: standalone blocking yes/no dialog
    - Bot config split into two sequential menus: difficulty & color
    - All menu data is constexpr in flash, no heap allocation
    - Updated copilot-instructions.md
    [board_menu.cpp, board_menu.h, main.cpp, menu_navigator.cpp, menu_navigator.h]
2026-02-17 Fix a bug that would render a square unresponsive if he was selected in a previous menu
    [board_menu.cpp, board_menu.h]
2026-02-18 Unified game pointer: replaced chessMoves, chessBot, chessLichess with a single ChessGame* activeGame variable
    [main.cpp]
2026-02-18 Set the correct orientation for the confirmation menu when a game is recovered on startup
    [main.cpp]
2026-02-19 Add resign feature
    - Hold king off board for 3 seconds to start resign, then 2 quick lift-return cycles to display a confirmation dialog
    - Web UI resign button for convenience
2026-02-19 Fixed a bug that didn't reset the confirmation menu and improved the UX when a player resign from the board
    [board_menu.cpp, chess_game.cpp, chess_game.h]
2026-02-24 Renamed the project and updated the materials list.
2026-03-01 Initial refactor of the game modes to take advantage of the new board manager.
2026-03-03 Improved and simplified the API :
    - Added insufficient material detection
    - Added FEN validation
    - Removed many redundant calls
    - Consolidated many scattered helpers
2026-03-04 Better naming for game mode and core lib classes/files. Added function `findPiece` to board logic.
2026-03-04 Reorganized the core library to better manage and segment the logic. The board can now rely only on ChessGame to handle a game of chess.
2026-03-05 Replace client-side live game navigation with server-side API endpoints backed by ChessGame's undo/redo system
    [bot_mode.cpp, bot_mode.h, game_mode.h, main.cpp, wifi_manager_esp32.cpp, wifi_manager_esp32.h]
2026-03-06 Better segmentation of board representation and state
2026-03-07 refactor: replace game mode inheritance with engine provider composition
    - Extract engine logic into EngineProvider base with StockfishProvider/LichessProvider
    - Merge StockfishMode/LichessMode into single BotMode composing an EngineProvider
    - Add persistent NDJSON streaming for Lichess game state
    [bot_mode.cpp, bot_mode.h, game_mode.cpp, game_mode.h, lichess_api.cpp, lichess_api.h]
2026-03-07 Many improvement and bug fixes
    [bot_mode.cpp, bot_mode.h, game_mode.cpp, game_mode.h, lichess_api.cpp, lichess_api.h]
2026-03-07 Fixed warnings and errors at build time and other minor changes
    [board_driver.cpp, bot_mode.cpp, bot_mode.h, game_mode.cpp, game_mode.h, lichess_api.cpp, main.cpp]
2026-03-08 Added ChessIterator namespace to centralize board iteration and eliminate raw nested loops across core library
2026-03-08 Fix false aggregate initialization errors by setting the esp32dev environment to C++17
2026-03-09 Optimized partition sizes
    [partitions.csv]
2026-03-14 Move generation optimization with pin-aware filtering
