Guignome01/OpenChess/BuildGuide/37_ALL_WIRES_SOLDERED_PERSPECTIVE1.webp

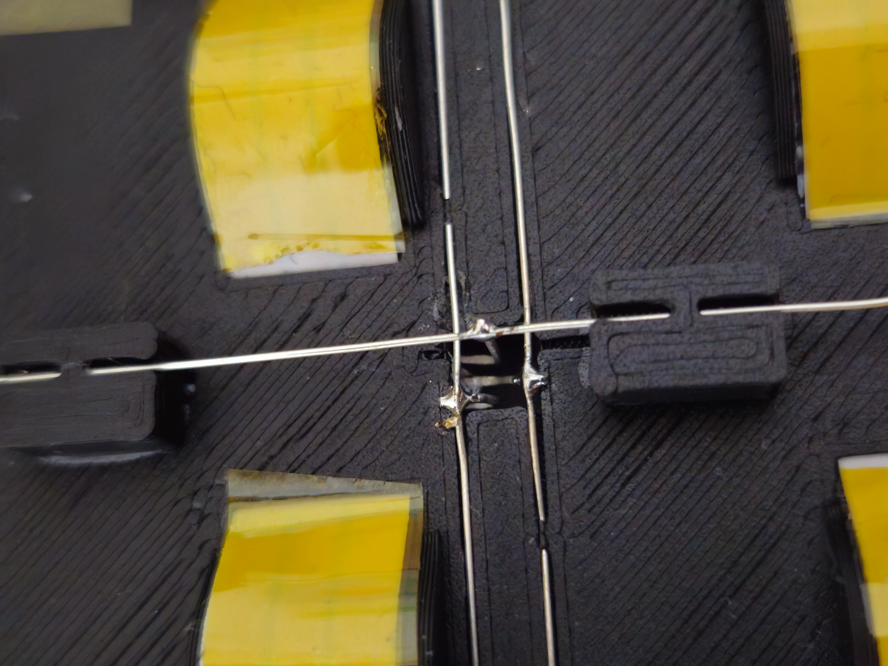
BuildGuide/37_ALL_WIRES_SOLDERED_PERSPECTIVE1.webp
